UAlberta-EcoCar/FCC-code-2015-2016/README.md

Code for Ualberta ecocar team hydrogen fuel fuel cell controller using an at32uc3c processor.
