UAlberta-EcoCar/FCC-code-2015-2016/Hardware/E-P-206-R1.2 Fuel Cell Control (Board to Board).brd

## EAGLE design Hardware/E-P-206-R1.2 Fuel Cell Control (Board to Board).brd (2017-02-24)

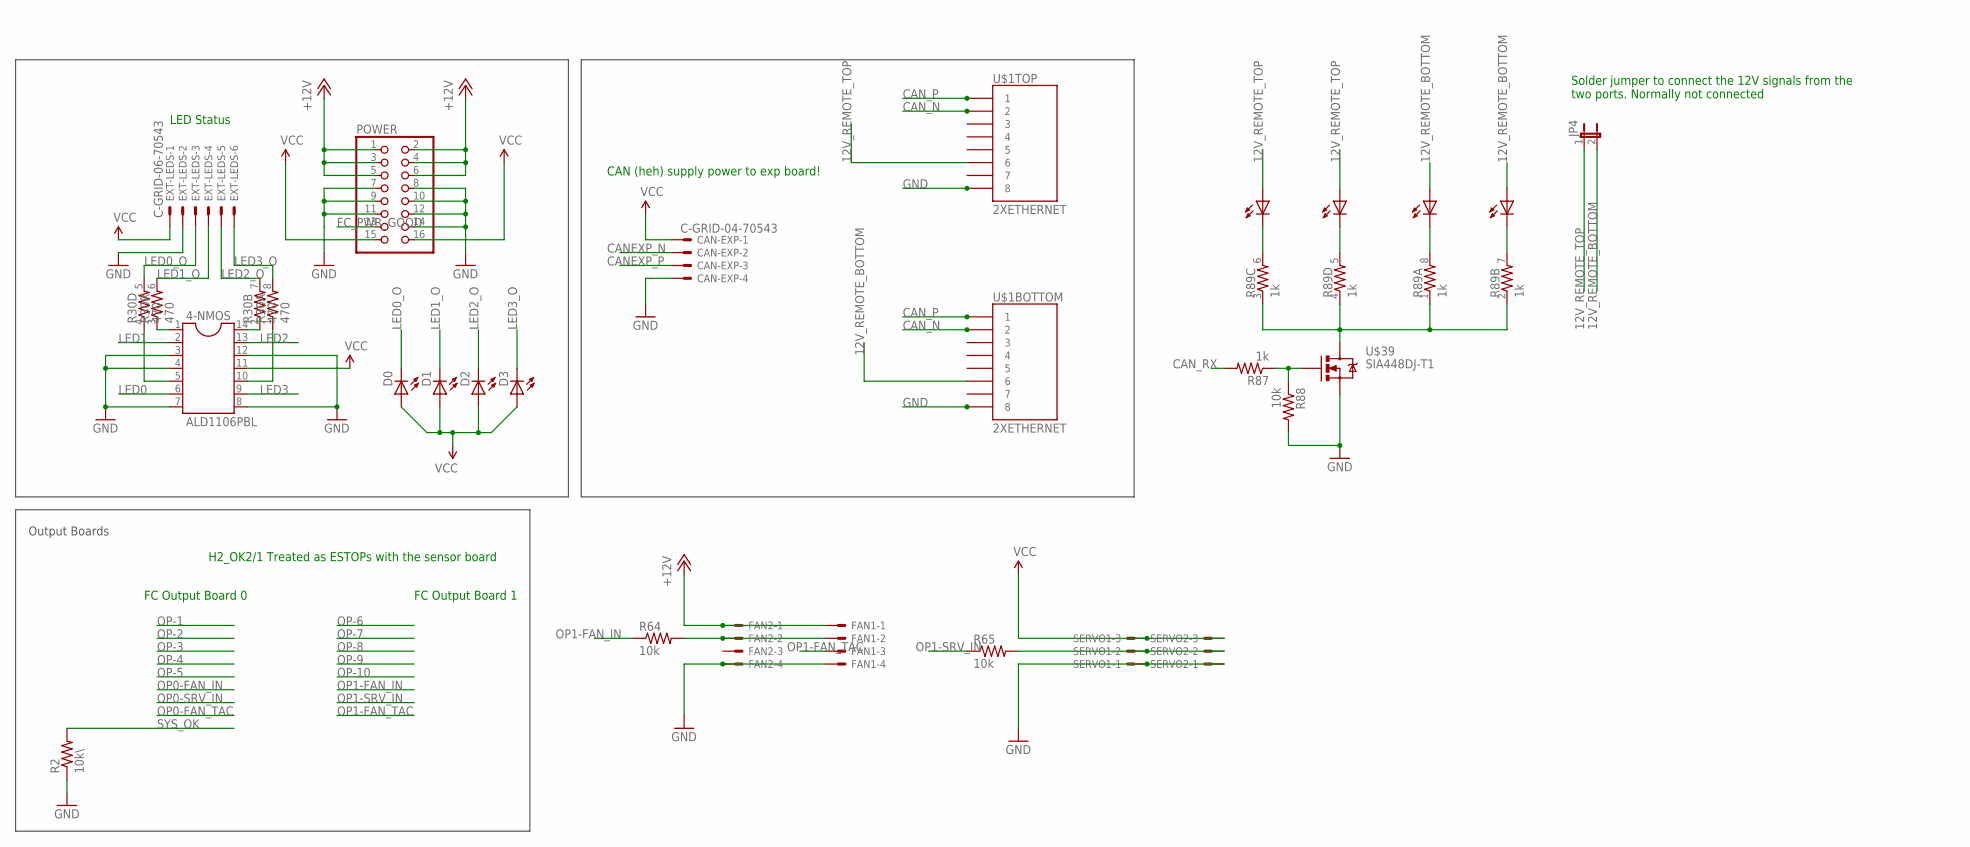
[picture p1: schematic E-P-206-R1.2 Fuel Cell Control (Board to Board).sch, sheet 1, Connectors]

Parts:
4-NMOS: ALD1106PBL; SOIC-14
CAN-EXP: C-GRID-04-70543; 70543-04
D0, D1, D2, D3: LED1206; LED-1206
EXT-LEDS: C-GRID-06-70543; 70543-06
FAN1, FAN2: C-GRID-04-70543; 70543-04
JP4: JUMPER-2SMD-NO; SJ_2S-NO
POWER: PINHD-2X8; 2X08
R2: 10k\; 0603-RES
R30: 470; 0603-ARV
R64, R65, R88: 10k; 0603-RES
R87: 1k; 0603-RES
R89: 1k; 0603-ARV
SERVO1, SERVO2: C-GRID-03-70543; 70543-03
U$1: 2XETHERNET
U$39: SIA448DJ-T1; SC70-6L

Connections:
12V_REMOTE_BOTTOM: JP4.2, U$1.B_6 (6), U$1.B_9 (A), U$1.B_11 (A)
12V_REMOTE_TOP: JP4.1, U$1.T_6 (6), U$1.T_9 (A), U$1.T_11 (A)
+12V: FAN1.1, FAN2.1, POWER.1, POWER.2, POWER.3, POWER.4, POWER.5, POWER.6; also elsewhere on the board
CANEXP_N: CAN-EXP.2; also elsewhere on the board
CANEXP_P: CAN-EXP.3; also elsewhere on the board
CAN_N: U$1.B_2 (2), U$1.T_2 (2); also elsewhere on the board
CAN_P: U$1.B_1 (1), U$1.T_1 (1); also elsewhere on the board
CAN_RX: R87.2; also elsewhere on the board
FC_PWR_GOOD: POWER.13; also elsewhere on the board
GND: 4-NMOS.3, 4-NMOS.4, 4-NMOS.7, 4-NMOS.8, 4-NMOS.12, CAN-EXP.4, EXT-LEDS.2, FAN1.4, FAN2.4, POWER.7, POWER.8, POWER.9, POWER.10, POWER.11, POWER.12, POWER.14, R2.1, R88.2, SERVO1.1, SERVO2.1, U$1.B_8 (8), U$1.T_8 (8), U$39.S@0 (S), U$39.S@1 (S); also elsewhere on the board
LED0: 4-NMOS.6; also elsewhere on the board
LED0_O: D0.C, EXT-LEDS.3, R30.5 (2)
LED1: 4-NMOS.2; also elsewhere on the board
LED1_O: D1.C, EXT-LEDS.4, R30.6 (2)
LED2: 4-NMOS.13; also elsewhere on the board
LED2_O: D2.C, EXT-LEDS.5, R30.7 (2)
LED3: 4-NMOS.9; also elsewhere on the board
LED3_O: D3.C, EXT-LEDS.6, R30.8 (2)
unnamed: 4-NMOS.5, R30.4 (1)
unnamed: 4-NMOS.1, R30.3 (1)
unnamed: 4-NMOS.14, R30.2 (1)
unnamed: 4-NMOS.10, R30.1
unnamed: R89.7 (2), U$1.B_10 (C)
unnamed: R89.5 (2), U$1.T_12 (C)
unnamed: R87.1, R88.1, U$39.G
unnamed: R89.6 (2), U$1.T_10 (C)
unnamed: R89.8 (2), U$1.B_12 (C)
unnamed: FAN1.2, FAN2.2, R64.2
unnamed: R65.2, SERVO1.2, SERVO2.2
unnamed: R89.1, R89.2 (1), R89.3 (1), R89.4 (1), U$39.D
OP1-FAN_IN: R64.1; also elsewhere on the board
OP1-FAN_TAC: FAN1.3; also elsewhere on the board
OP1-SRV_IN: R65.1; also elsewhere on the board
SYS_OK: R2.2; also elsewhere on the board
VCC: 4-NMOS.11, CAN-EXP.1, D0.A, D1.A, D2.A, D3.A, EXT-LEDS.1, POWER.15, POWER.16, SERVO1.3, SERVO2.3; also elsewhere on the board

Notes on the sheet:
FC Output Board 0
Output Boards
FC Output Board 1
LED Status
H2_OK2/1 Treated as ESTOPs with the sensor board
CAN (heh) supply power to exp board!
Solder jumper to connect the 12V signals from the two ports. Normally not connected

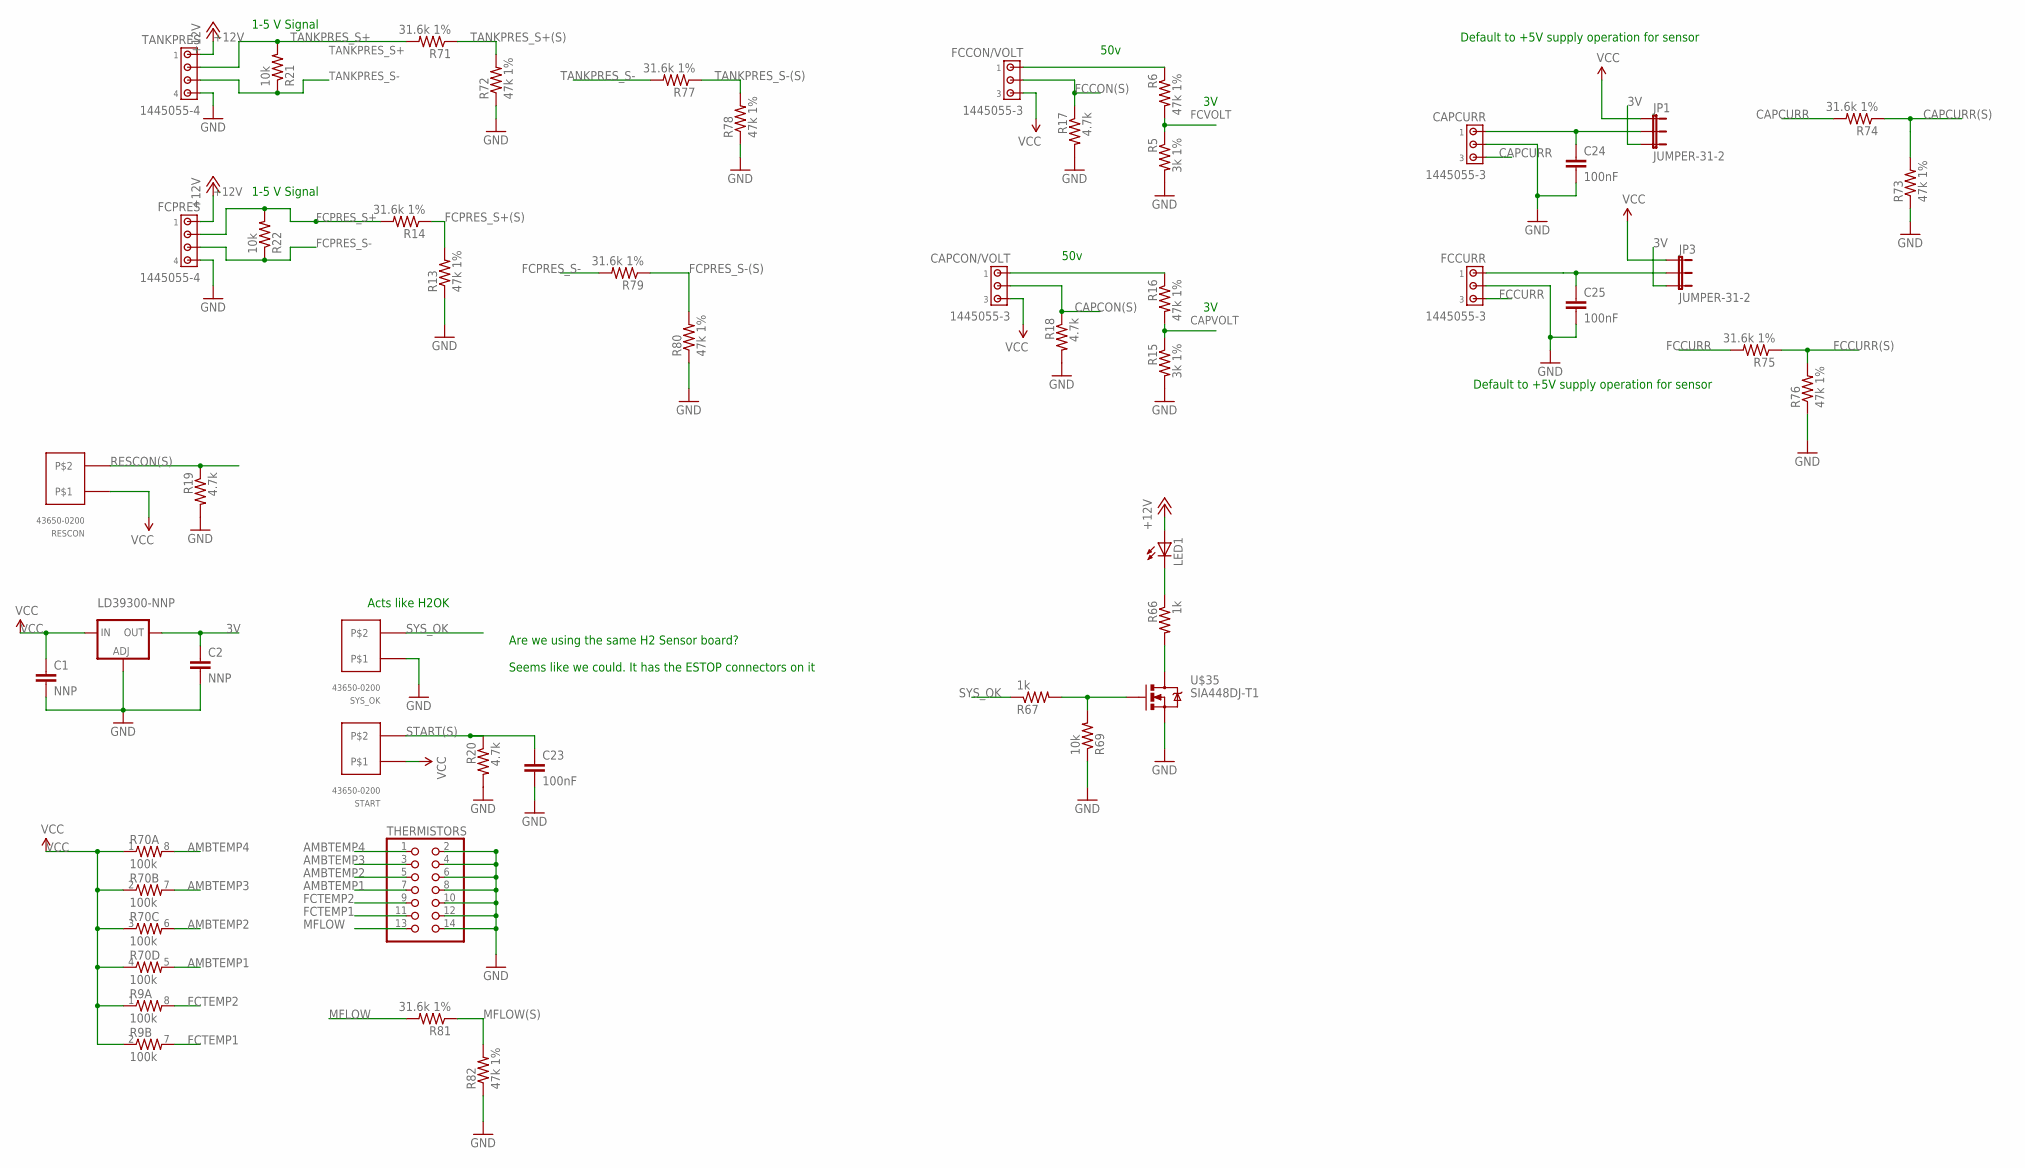
[picture p2: schematic E-P-206-R1.2 Fuel Cell Control (Board to Board).sch, sheet 2, Sensors]

Parts:
C1, C2: NNP; 1206
C23, C24, C25: 100nF; 0603-CAP
CAPCON/VOLT: 1445055-3
CAPCURR: 1445055-3
FCCON/VOLT: 1445055-3
FCCURR: 1445055-3
FCPRES: 1445055-4
JP1, JP3: JUMPER-31-2; SJ_3_PASTE1&2
LD39300-NNP: LD117ADT50TR; DPACK
LED1: LED1206; LED-1206
R5, R15: 3k 1%; 0603-RES
R6, R13, R16, R72, R73, R76, R78, R80, R82: 47k 1%; 0603-RES
R9, R70: 100k; 0603-ARV
R14, R71, R74, R75, R77, R79, R81: 31.6k 1%; 0603-RES
R17, R18, R19, R20: 4.7k; 0603-RES
R21, R22, R69: 10k; 0603-RES
R66, R67: 1k; 0603-RES
RESCON: 43650-0200
START: 43650-0200
SYS_OK: 43650-0200
TANKPRES: 1445055-4
THERMISTORS: PINHD-2X7; 2X07
U$35: SIA448DJ-T1; SC70-6L

Connections:
3V: C2.1, JP1.3, JP3.3, LD39300-NNP.4 (OUT)
+12V: FCPRES.1, LED1.A, TANKPRES.1; also elsewhere on the board
AMBTEMP1: R70.5 (2), THERMISTORS.7; also elsewhere on the board
AMBTEMP2: R70.6 (2), THERMISTORS.5; also elsewhere on the board
AMBTEMP3: R70.7 (2), THERMISTORS.3; also elsewhere on the board
AMBTEMP4: R70.8 (2), THERMISTORS.1; also elsewhere on the board
CAPCON(S): CAPCON/VOLT.2, R18.1; also elsewhere on the board
CAPCURR: CAPCURR.3, R74.2
CAPCURR(S): R73.2, R74.1; also elsewhere on the board
CAPVOLT: R15.1, R16.2; also elsewhere on the board
FCCON(S): FCCON/VOLT.2, R17.1; also elsewhere on the board
FCCURR: FCCURR.3, R75.2
FCCURR(S): R75.1, R76.2; also elsewhere on the board
FCPRES_S+: FCPRES.2, R14.2, R22.2
FCPRES_S+(S): R13.2, R14.1; also elsewhere on the board
FCPRES_S-: FCPRES.3, R22.1, R79.2
FCPRES_S-(S): R79.1, R80.2; also elsewhere on the board
FCTEMP1: R9.7 (2), THERMISTORS.11; also elsewhere on the board
FCTEMP2: R9.8 (2), THERMISTORS.9; also elsewhere on the board
FCVOLT: R5.1, R6.2; also elsewhere on the board
FCVOLT+: FCCON/VOLT.1, R6.1
FCVOLT+1: CAPCON/VOLT.1, R16.1
GND: C1.2, C2.2, C23.2, C24.2, C25.2, CAPCURR.2, FCCURR.2, FCPRES.4, LD39300-NNP.1 (ADJ), R5.2, R13.1, R15.2, R17.2, R18.2, R19.2, R20.2, R69.1, R72.1, R73.1, R76.1, R78.1, R80.1, R82.1, SYS_OK.P$2, TANKPRES.4, THERMISTORS.2, THERMISTORS.4, THERMISTORS.6, THERMISTORS.8, THERMISTORS.10, THERMISTORS.12, THERMISTORS.14, U$35.S@0 (S), U$35.S@1 (S); also elsewhere on the board
MFLOW: R81.2, THERMISTORS.13
MFLOW(S): R81.1, R82.2; also elsewhere on the board
unnamed: R66.2, U$35.D
unnamed: R67.2, R69.2, U$35.G
unnamed: LED1.C, R66.1
unnamed: C24.1, CAPCURR.1, JP1.2
unnamed: C25.1, FCCURR.1, JP3.2
RESCON(S): R19.1, RESCON.P$1; also elsewhere on the board
START(S): C23.1, R20.1, START.P$1; also elsewhere on the board
SYS_OK: R67.1, SYS_OK.P$1; also elsewhere on the board
TANKPRES_S+: R21.2, R71.2, TANKPRES.2
TANKPRES_S+(S): R71.1, R72.2; also elsewhere on the board
TANKPRES_S-: R21.1, R77.2, TANKPRES.3
TANKPRES_S-(S): R77.1, R78.2; also elsewhere on the board
VCC: C1.1, CAPCON/VOLT.3, FCCON/VOLT.3, JP1.1, JP3.1, LD39300-NNP.3 (IN), R9.1, R9.2 (1), R70.1, R70.2 (1), R70.3 (1), R70.4 (1), RESCON.P$2, START.P$2; also elsewhere on the board

Notes on the sheet:
Are we using the same H2 Sensor board? Seems like we could. It has the ESTOP connectors on it
Acts like H2OK
1-5 V Signal
50v
Default to +5V supply operation for sensor

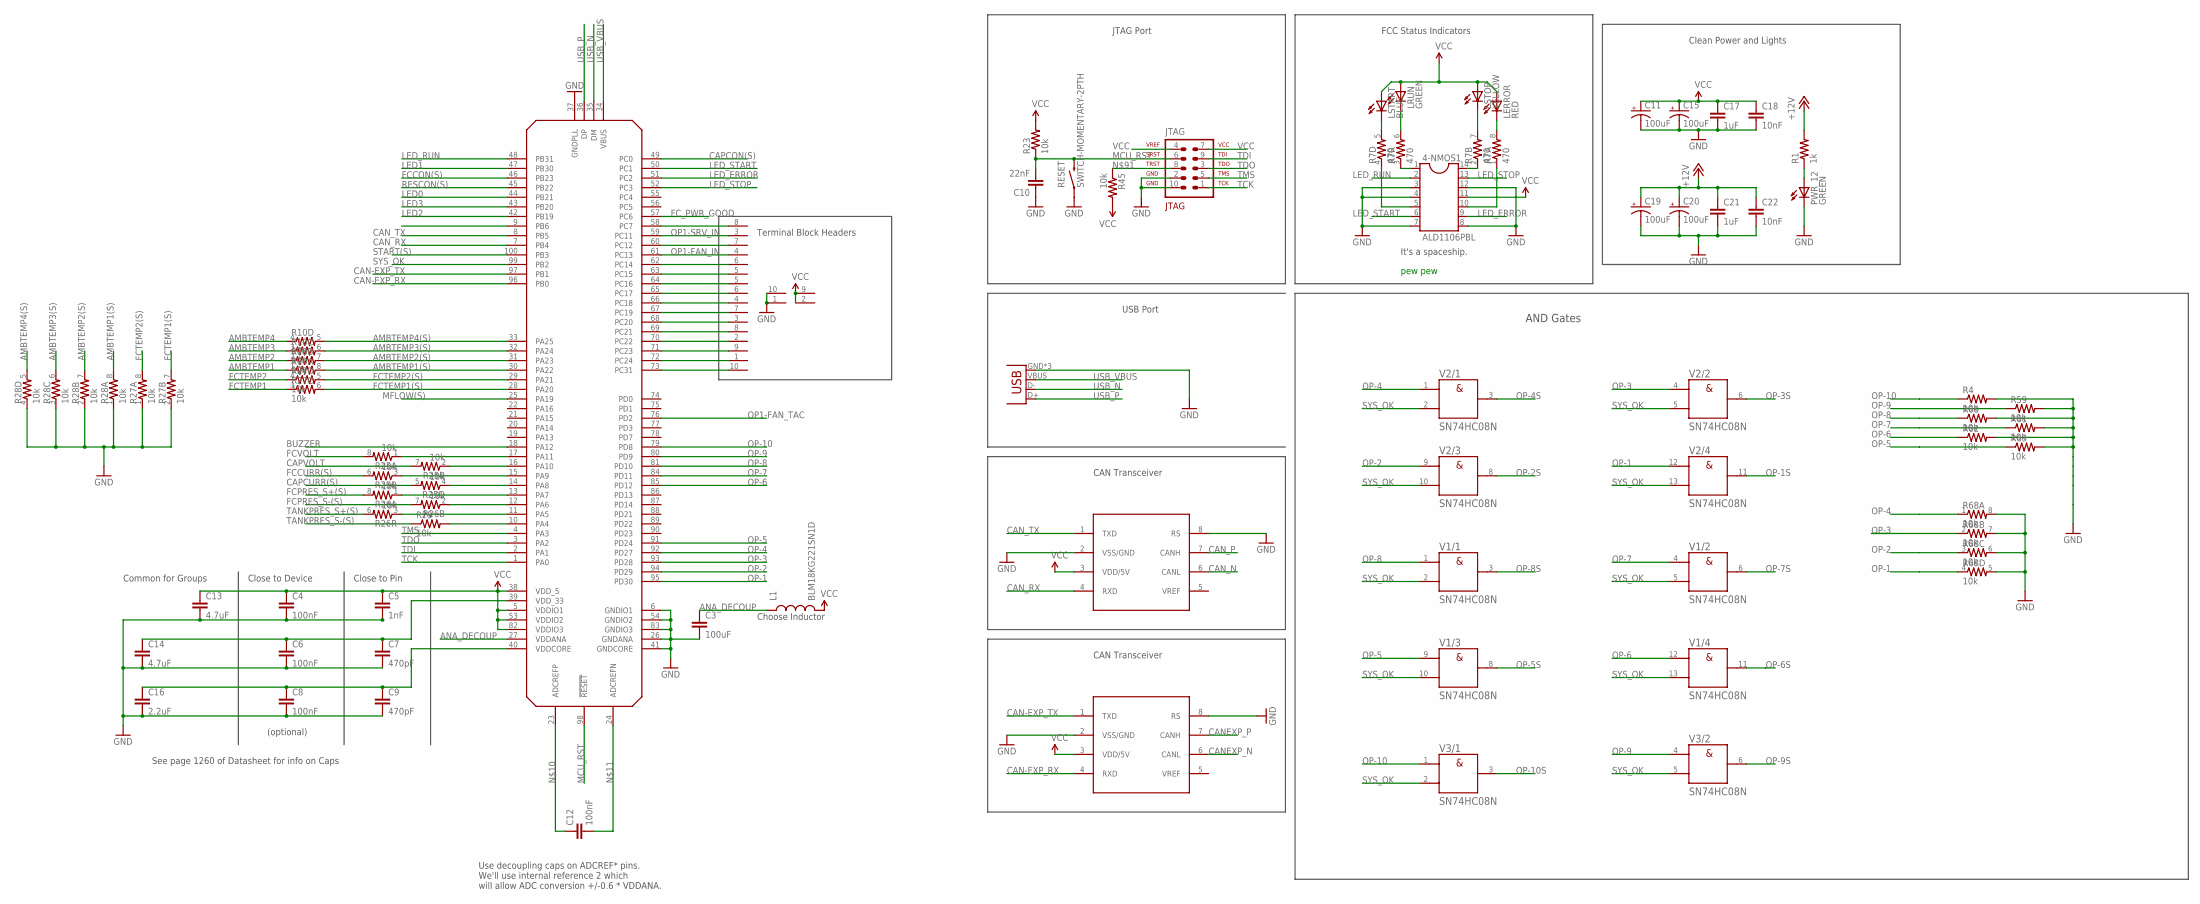
[picture p3: schematic E-P-206-R1.2 Fuel Cell Control (Board to Board).sch, sheet 3, MCU]

Parts:
4-NMOS1: ALD1106PBL; SOIC-14
C3: 100uF; 0805
C4, C6, C8: 100nF; 0603-CAP
C5: 1nF; 0603-CAP
C7, C9: 470pF; 0603-CAP
C10: 22nF; 0603-CAP
C11, C15, C19, C20: 100uF; PANASONIC_C
C12: 100nF; 0805
C13, C14: 4.7uF; 0805
C16: 2.2uF; 0805
C17, C21: 1uF; 0805
C18, C22: 10nF; 0603-CAP
JP2: USB; USB-MICROB
JTAG: 2x5; AVR-JTAG-10
L1: BLM18KG221SN1D; 0603
LERROR: RED; LED-1206
LRUN: GREEN; LED-1206
LSTART: BLUE; LED-1206
LSTOP: YELLOW; LED-1206
MCU: AT32UC3C1512; TQFP100
PWR_12: GREEN; LED-1206
R1: 1k; 0603-RES
R4, R23, R29, R45, R59, R60, R61, R62, R63: 10k; 0603-RES
R7: 470; 0603-ARV
R10, R25, R26, R27, R28, R68: 10k; 0603-ARV
RESET: SWITCH-MOMENTARY-2PTH; TACTILE-PTH
U$2, U$3: 10X1PCBBLOCK
U$4, U$36: MCP2551; 8-SOIC
V1, V2, V3: SN74HC08N; DIL14

Connections:
+12V: C19.+, C20.+, C21.1, C22.1, R1.2; also elsewhere on the board
AMBTEMP1: R10.1; also elsewhere on the board
AMBTEMP1(S): MCU.30 (PA22), R10.8 (2), R28.8 (2)
AMBTEMP2: R10.2 (1); also elsewhere on the board
AMBTEMP2(S): MCU.31 (PA23), R10.7 (2), R28.7 (2)
AMBTEMP3: R10.3 (1); also elsewhere on the board
AMBTEMP3(S): MCU.32 (PA24), R10.6 (2), R28.6 (2)
AMBTEMP4: R10.4 (1); also elsewhere on the board
AMBTEMP4(S): MCU.33 (PA25), R10.5 (2), R28.5 (2)
ANA_DECOUP: C3.1, L1.1, MCU.27 (VDDANA)
BUZZER: MCU.18 (PA12); also elsewhere on the board
CAN-EXP_RX: MCU.96 (PB0), U$36.4 (RXD)
CAN-EXP_TX: MCU.97 (PB1), U$36.1 (TXD)
CANEXP_N: U$36.6 (CANL); also elsewhere on the board
CANEXP_P: U$36.7 (CANH); also elsewhere on the board
CAN_N: U$4.6 (CANL); also elsewhere on the board
CAN_P: U$4.7 (CANH); also elsewhere on the board
CAN_RX: MCU.7 (PB4), U$4.4 (RXD); also elsewhere on the board
CAN_TX: MCU.8 (PB5), U$4.1 (TXD)
CAPCON(S): MCU.49 (PC0); also elsewhere on the board
CAPCURR(S): R25.5 (2); also elsewhere on the board
CAPVOLT: R25.7 (2); also elsewhere on the board
FCCON(S): MCU.46 (PB23); also elsewhere on the board
FCCURR(S): R25.6 (2); also elsewhere on the board
FCPRES_S+(S): R26.8 (2); also elsewhere on the board
FCPRES_S-(S): R26.7 (2); also elsewhere on the board
FCTEMP1: R27.3 (1); also elsewhere on the board
FCTEMP1(S): MCU.28 (PA20), R27.6 (2), R27.7 (2)
FCTEMP2: R27.4 (1); also elsewhere on the board
FCTEMP2(S): MCU.29 (PA21), R27.5 (2), R27.8 (2)
FCVOLT: R25.8 (2); also elsewhere on the board
FC_PWR_GOOD: MCU.57 (PC6); also elsewhere on the board
GND: 4-NMOS1.3, 4-NMOS1.4, 4-NMOS1.7, 4-NMOS1.8, 4-NMOS1.12, C3.2, C4.2, C5.2, C6.2, C7.2, C8.2, C9.2, C10.1, C11.-, C13.2, C14.2, C15.-, C16.2, C17.2, C18.2, C19.-, C20.-, C21.2, C22.2, JP2.GND, JP2.MT1 (GND), JP2.MT2 (GND), JTAG.2, JTAG.10, MCU.6 (GNDIO1), MCU.26 (GNDANA), MCU.37 (GNDPLL), MCU.41 (GNDCORE), MCU.54 (GNDIO2), MCU.83 (GNDIO3), PWR_12.C, R4.2, R27.1, R27.2 (1), R28.1, R28.2 (1), R28.3 (1), R28.4 (1), R59.2, R60.2, R61.2, R62.2, R63.2, R68.5 (2), R68.6 (2), R68.7 (2), R68.8 (2), RESET.1, U$2.10, U$3.1, U$4.2 (VSS/GND), U$4.8 (RS), U$36.2 (VSS/GND), U$36.8 (RS), V1.7 (-UB), V2.7 (-UB), V3.7 (-UB); also elsewhere on the board
LED0: MCU.44 (PB21); also elsewhere on the board
LED1: MCU.47 (PB30); also elsewhere on the board
LED2: MCU.42 (PB19); also elsewhere on the board
LED3: MCU.43 (PB20); also elsewhere on the board
LED_ERROR: 4-NMOS1.9, MCU.51 (PC2)
LED_RUN: 4-NMOS1.2, MCU.48 (PB31)
LED_START: 4-NMOS1.6, MCU.50 (PC1)
LED_STOP: 4-NMOS1.13, MCU.52 (PC3)
MCU_RST: C10.2, JTAG.6, MCU.98 (!RESET), R23.1, RESET.3 (2)
MFLOW(S): MCU.25 (PA19); also elsewhere on the board
unnamed: MCU.10 (PA4), R29.2
unnamed: MCU.12 (PA6), R26.2 (1)
unnamed: MCU.13 (PA7), R26.1
unnamed: C6.1, C7.1, C14.1, MCU.39 (VDD_33)
unnamed: C8.1, C9.1, C16.1, MCU.40 (VDDCORE)
unnamed: C12.1, MCU.23 (ADCREFP)
unnamed: C12.2, MCU.24 (ADCREFN)
unnamed: MCU.72 (PC24), U$2.1
unnamed: MCU.11 (PA5), R26.3 (1)
unnamed: MCU.70 (PC22), U$2.2
unnamed: MCU.68 (PC20), U$2.3
unnamed: MCU.14 (PA8), R25.4 (1)
unnamed: MCU.66 (PC18), U$2.4
unnamed: MCU.64 (PC16), U$2.5
unnamed: MCU.62 (PC14), U$2.6
unnamed: LSTART.C, R7.5 (2)
unnamed: LRUN.C, R7.6 (2)
unnamed: MCU.15 (PA9), R25.3 (1)
unnamed: MCU.16 (PA10), R25.2 (1)
unnamed: MCU.17 (PA11), R25.1
unnamed: MCU.60 (PC12), U$2.7
unnamed: MCU.58 (PC7), U$2.8
unnamed: 4-NMOS1.5, R7.4 (1)
unnamed: 4-NMOS1.1, R7.3 (1)
unnamed: PWR_12.A, R1.1
unnamed: MCU.63 (PC15), U$3.5
unnamed: MCU.65 (PC17), U$3.6
unnamed: MCU.67 (PC19), U$3.7
unnamed: MCU.69 (PC21), U$3.8
unnamed: MCU.71 (PC23), U$3.9
unnamed: MCU.73 (PC31), U$3.10
unnamed: 4-NMOS1.14, R7.2 (1)
unnamed: 4-NMOS1.10, R7.1
unnamed: LSTOP.C, R7.7 (2)
unnamed: LERROR.C, R7.8 (2)
unnamed: JTAG.8, R45.1
OP1-FAN_IN: MCU.61 (PC13), U$3.4; also elsewhere on the board
OP1-FAN_TAC: MCU.76 (PD2); also elsewhere on the board
OP1-SRV_IN: MCU.59 (PC11), U$3.3; also elsewhere on the board
OP-1: MCU.95 (PD30), R68.4 (1), V2.12 (A)
OP-1S: V2.11 (Y); also elsewhere on the board
OP-2: MCU.94 (PD29), R68.3 (1), V2.9 (A)
OP-2S: V2.8 (Y); also elsewhere on the board
OP-3: MCU.93 (PD28), R68.2 (1), V2.4 (A)
OP-3S: V2.6 (Y); also elsewhere on the board
OP-4: MCU.92 (PD27), R68.1, V2.1 (A)
OP-4S: V2.3 (Y); also elsewhere on the board
OP-5: MCU.91 (PD24), R63.1, V1.9 (A)
OP-5S: V1.8 (Y); also elsewhere on the board
OP-6: MCU.85 (PD12), R62.1, V1.12 (A)
OP-6S: V1.11 (Y); also elsewhere on the board
OP-7: MCU.84 (PD11), R61.1, V1.4 (A)
OP-7S: V1.6 (Y); also elsewhere on the board
OP-8: MCU.81 (PD10), R60.1, V1.1 (A)
OP-8S: V1.3 (Y); also elsewhere on the board
OP-9: MCU.80 (PD9), R59.1, V3.4 (A)
OP-9S: V3.6 (Y); also elsewhere on the board
OP-10: MCU.79 (PD8), R4.1, V3.1 (A)
OP-10S: V3.3 (Y); also elsewhere on the board
RESCON(S): MCU.45 (PB22); also elsewhere on the board
START(S): MCU.100 (PB3); also elsewhere on the board
SYS_OK: MCU.99 (PB2), V1.2 (B), V1.5 (B), V1.10 (B), V1.13 (B), V2.2 (B), V2.5 (B), V2.10 (B), V2.13 (B), V3.2 (B), V3.5 (B); also elsewhere on the board
TANKPRES_S+(S): R26.6 (2); also elsewhere on the board
TANKPRES_S-(S): R29.1; also elsewhere on the board
TCK: JTAG.1, MCU.1 (PA0)
TDI: JTAG.9, MCU.2 (PA1)
TDO: JTAG.3, MCU.3 (PA2)
TMS: JTAG.5, MCU.4 (PA3)
USB_N: JP2.D-, MCU.35 (DM)
USB_P: JP2.D+, MCU.36 (DP)
USB_VBUS: JP2.VBUS, MCU.34 (VBUS)
VCC: 4-NMOS1.11, C4.1, C5.1, C11.+, C13.1, C15.+, C17.1, C18.1, JTAG.4, JTAG.7, L1.2, LERROR.A, LRUN.A, LSTART.A, LSTOP.A, MCU.5 (VDDIO1), MCU.38 (VDD_5), MCU.53 (VDDIO2), MCU.82 (VDDIO3), R23.2, R45.2, U$2.9, U$3.2, U$4.3 (VDD/5V), U$36.3 (VDD/5V), V1.14 (+UB), V2.14 (+UB), V3.14 (+UB); also elsewhere on the board

Notes on the sheet:
Choose Inductor
Use decoupling caps on ADCREF* pins. We'll use internal reference 2 which will allow ADC conversion +/-0.6 * VDDANA.
Close to Pin
Close to Device
Common for Groups
JTAG Port
USB Port
(optional)
See page 1260 of Datasheet for info on Caps
CAN Transceiver
Terminal Block Headers
Clean Power and Lights
FCC Status Indicators
It's a spaceship.
pew pew
AND Gates

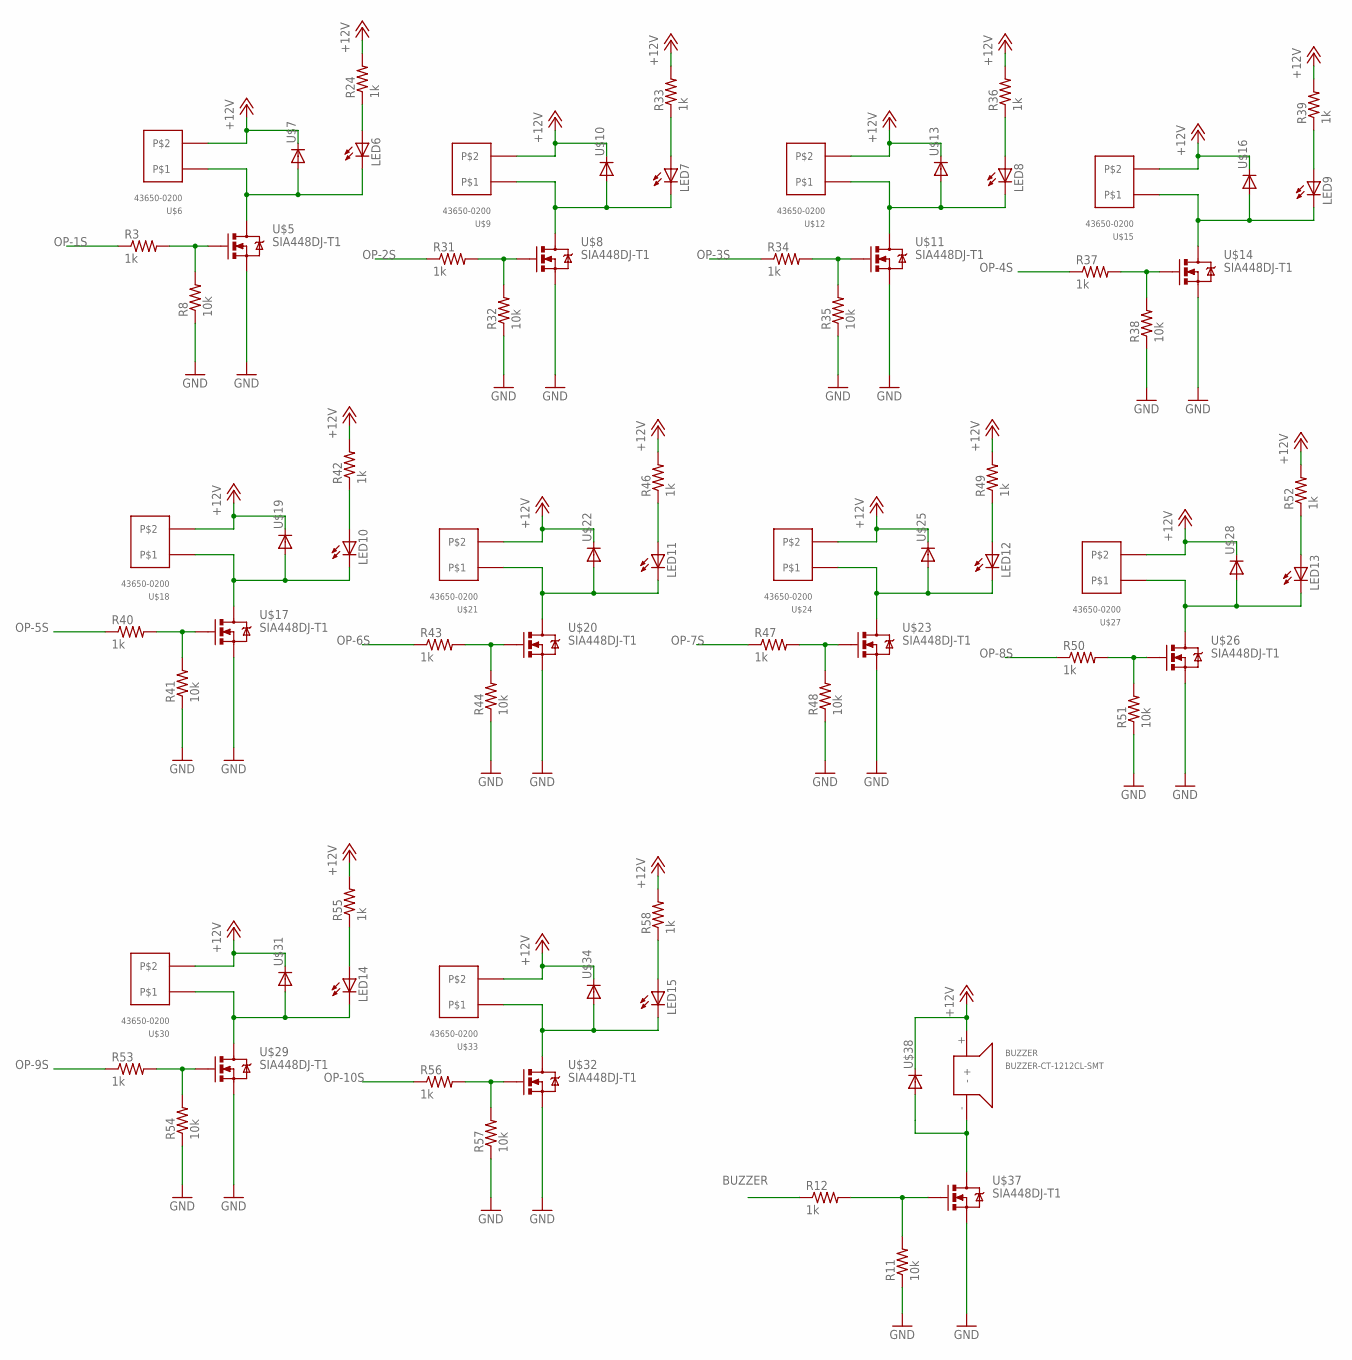
[picture p4: schematic E-P-206-R1.2 Fuel Cell Control (Board to Board).sch, sheet 4, Output Drivers]

Parts:
BUZZER: BUZZER-CT-1212CL-SMT; CT-1212CL-SMT
LED6, LED7, LED8, LED9, LED10, LED11, LED12, LED13, LED14, LED15: LED1206; LED-1206
R3, R12, R24, R31, R33, R34, R36, R37, R39, R40, R42, R43, R46, R47, R49, R50, R52, R53, R55, R56, R58: 1k; 0603-RES
R8, R11, R32, R35, R38, R41, R44, R48, R51, R54, R57: 10k; 0603-RES
U$5, U$8, U$11, U$14, U$17, U$20, U$23, U$26, U$29, U$32, U$37: SIA448DJ-T1; SC70-6L
U$6, U$9, U$12, U$15, U$18, U$21, U$24, U$27, U$30, U$33: 43650-0200
U$7, U$10, U$13, U$16, U$19, U$22, U$25, U$28, U$31, U$34, U$38: DIODE-DO214AC; DO214AC

Connections:
+12V: BUZZER.+, R24.2, R33.2, R36.2, R39.2, R42.2, R46.2, R49.2, R52.2, R55.2, R58.2, U$6.P$1, U$7.C, U$9.P$1, U$10.C, U$12.P$1, U$13.C, U$15.P$1, U$16.C, U$18.P$1, U$19.C, U$21.P$1, U$22.C, U$24.P$1, U$25.C, U$27.P$1, U$28.C, U$30.P$1, U$31.C, U$33.P$1, U$34.C, U$38.C; also elsewhere on the board
BUZZER: R12.1; also elsewhere on the board
GND: R8.1, R11.1, R32.1, R35.1, R38.1, R41.1, R44.1, R48.1, R51.1, R54.1, R57.1, U$5.S@0 (S), U$5.S@1 (S), U$8.S@0 (S), U$8.S@1 (S), U$11.S@0 (S), U$11.S@1 (S), U$14.S@0 (S), U$14.S@1 (S), U$17.S@0 (S), U$17.S@1 (S), U$20.S@0 (S), U$20.S@1 (S), U$23.S@0 (S), U$23.S@1 (S), U$26.S@0 (S), U$26.S@1 (S), U$29.S@0 (S), U$29.S@1 (S), U$32.S@0 (S), U$32.S@1 (S), U$37.S@0 (S), U$37.S@1 (S); also elsewhere on the board
unnamed: R3.2, R8.2, U$5.G
unnamed: R11.2, R12.2, U$37.G
unnamed: LED6.A, R24.1
unnamed: LED6.C, U$5.D, U$6.P$2, U$7.A
unnamed: R31.2, R32.2, U$8.G
unnamed: LED7.C, U$8.D, U$9.P$2, U$10.A
unnamed: LED7.A, R33.1
unnamed: R34.2, R35.2, U$11.G
unnamed: BUZZER.-, U$37.D, U$38.A
unnamed: LED8.C, U$11.D, U$12.P$2, U$13.A
unnamed: LED8.A, R36.1
unnamed: R37.2, R38.2, U$14.G
unnamed: LED9.C, U$14.D, U$15.P$2, U$16.A
unnamed: LED9.A, R39.1
unnamed: R40.2, R41.2, U$17.G
unnamed: LED10.C, U$17.D, U$18.P$2, U$19.A
unnamed: LED13.A, R52.1
unnamed: R43.2, R44.2, U$20.G
unnamed: LED11.C, U$20.D, U$21.P$2, U$22.A
unnamed: LED12.A, R49.1
unnamed: R47.2, R48.2, U$23.G
unnamed: LED12.C, U$23.D, U$24.P$2, U$25.A
unnamed: LED11.A, R46.1
unnamed: R50.2, R51.2, U$26.G
unnamed: LED13.C, U$26.D, U$27.P$2, U$28.A
unnamed: LED10.A, R42.1
unnamed: R53.2, R54.2, U$29.G
unnamed: LED14.C, U$29.D, U$30.P$2, U$31.A
unnamed: LED14.A, R55.1
unnamed: R56.2, R57.2, U$32.G
unnamed: LED15.C, U$32.D, U$33.P$2, U$34.A
unnamed: LED15.A, R58.1
OP-1S: R3.1; also elsewhere on the board
OP-2S: R31.1; also elsewhere on the board
OP-3S: R34.1; also elsewhere on the board
OP-4S: R37.1; also elsewhere on the board
OP-5S: R40.1; also elsewhere on the board
OP-6S: R43.1; also elsewhere on the board
OP-7S: R47.1; also elsewhere on the board
OP-8S: R50.1; also elsewhere on the board
OP-9S: R53.1; also elsewhere on the board
OP-10S: R56.1; also elsewhere on the board

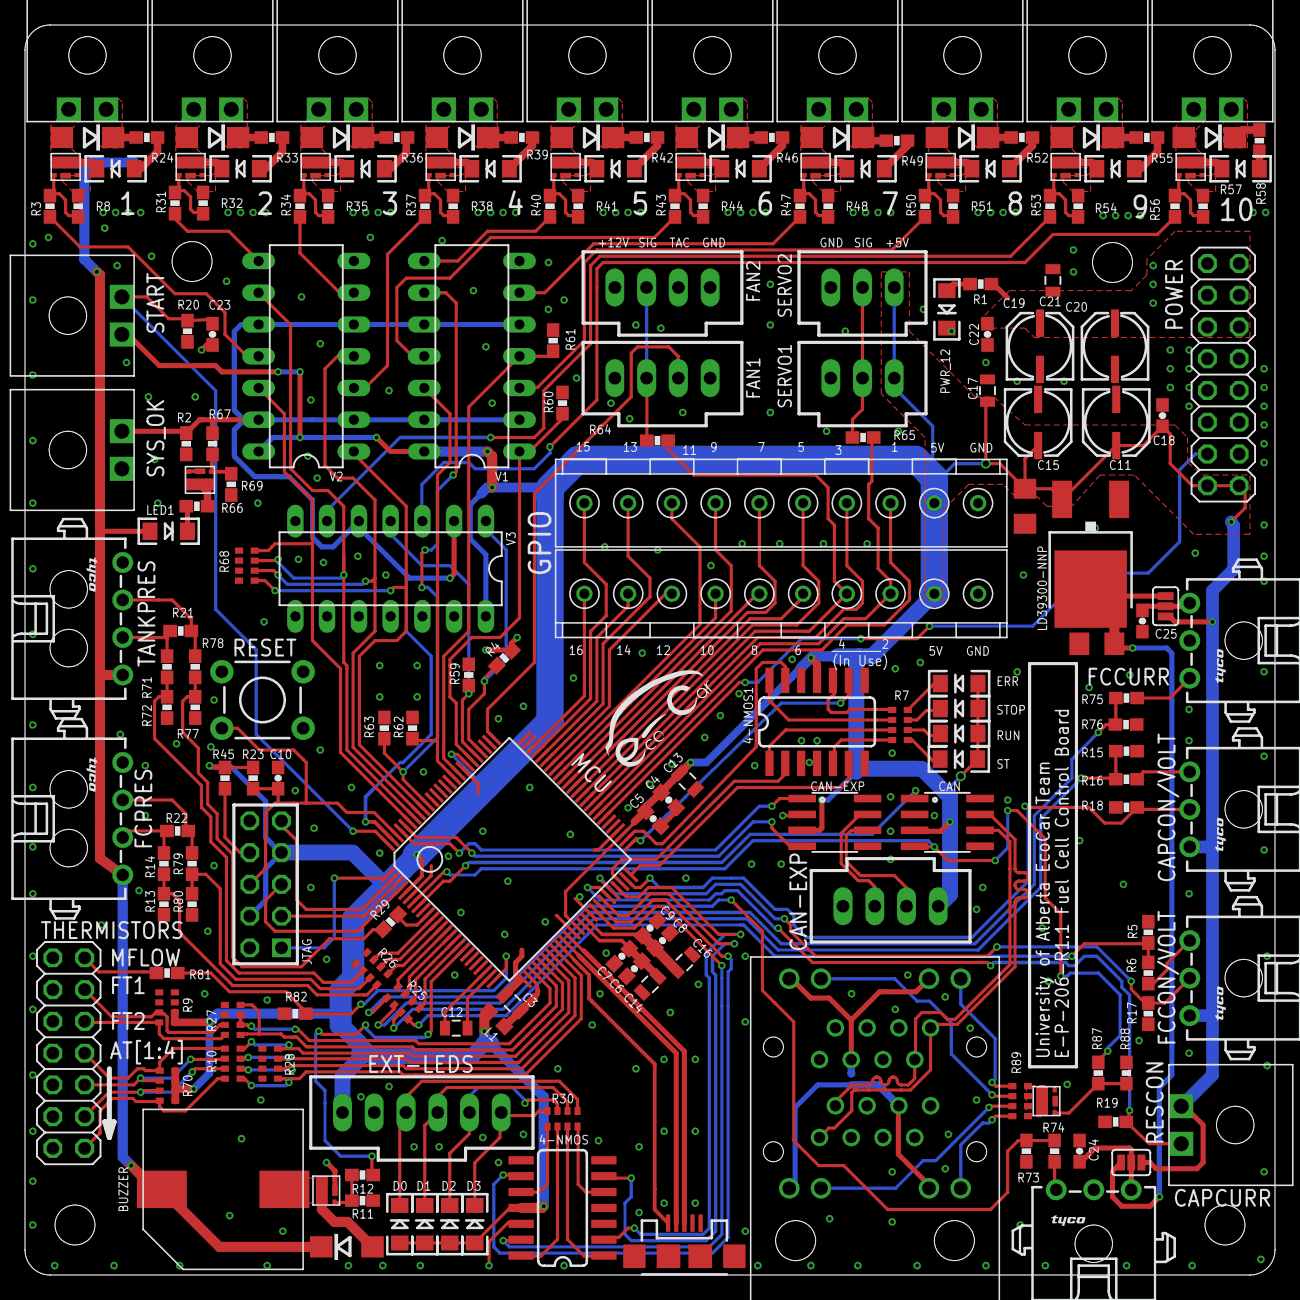
[picture p5: board E-P-206-R1.2 Fuel Cell Control (Board to Board).brd from above]

Board: 2 copper layers, 100.0 x 100.0 mm, 201 parts (1 on the bottom side), 180 nets.
