UAlberta-EcoCar/FCC-code-2015-2016/Hardware/E-P-206-R2.0.0_Fuel_Cell_Controller.brd

## EAGLE design Hardware/E-P-206-R2.0.0_Fuel_Cell_Controller.brd (2017-02-24)

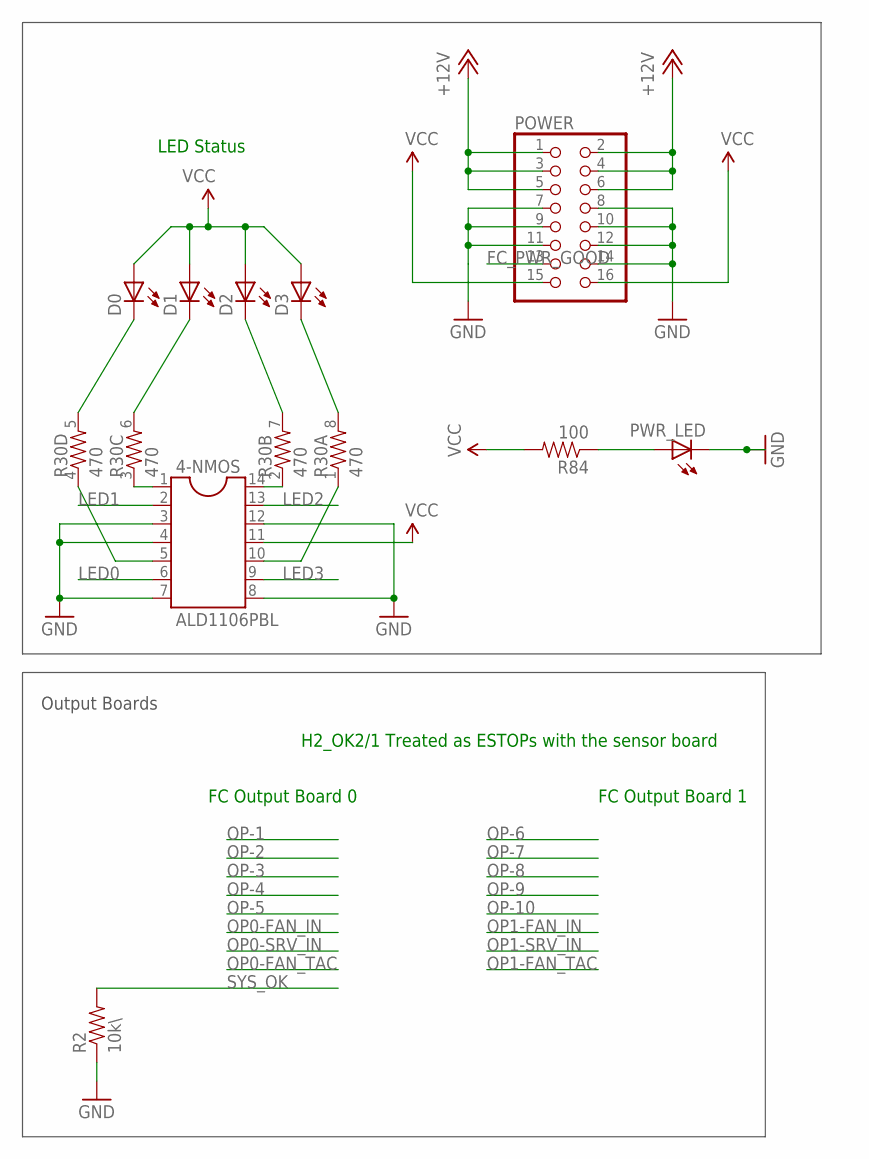
[picture p6: schematic E-P-206-R2.0.0_Fuel_Cell_Controller.sch, sheet 1, Connectors]

Parts:
4-NMOS: ALD1106PBL; SOIC-14
D0, D1, D2, D3: LED1206; LED-1206
POWER: PINHD-2X8; 2X08
PWR_LED: LED1206; LED-1206
R2: 10k\; 0603-RES
R30: 470; 0603-ARV
R84: 100; 0603-RES

Connections:
+12V: POWER.1, POWER.2, POWER.3, POWER.4, POWER.5, POWER.6; also elsewhere on the board
FC_PWR_GOOD: POWER.13
GND: 4-NMOS.3, 4-NMOS.4, 4-NMOS.7, 4-NMOS.8, 4-NMOS.12, POWER.7, POWER.8, POWER.9, POWER.10, POWER.11, POWER.12, POWER.14, PWR_LED.C, R2.1; also elsewhere on the board
LED0: 4-NMOS.6; also elsewhere on the board
LED0_O: D0.C, R30.5 (2)
LED1: 4-NMOS.2; also elsewhere on the board
LED1_O: D1.C, R30.6 (2)
LED2: 4-NMOS.13; also elsewhere on the board
LED2_O: D2.C, R30.7 (2)
LED3: 4-NMOS.9; also elsewhere on the board
LED3_O: D3.C, R30.8 (2)
unnamed: 4-NMOS.5, R30.4 (1)
unnamed: 4-NMOS.1, R30.3 (1)
unnamed: 4-NMOS.14, R30.2 (1)
unnamed: 4-NMOS.10, R30.1
unnamed: PWR_LED.A, R84.1
SYS_OK: R2.2; also elsewhere on the board
VCC: 4-NMOS.11, D0.A, D1.A, D2.A, D3.A, POWER.15, POWER.16, R84.2; also elsewhere on the board

Notes on the sheet:
FC Output Board 0
Output Boards
FC Output Board 1
LED Status
H2_OK2/1 Treated as ESTOPs with the sensor board
