UAlberta-EcoCar/FCC-code-2015-2016/Hardware/E-P-206-R2.0.0_Fuel_Cell_Controller.brd

## EAGLE design Hardware/E-P-206-R2.0.0_Fuel_Cell_Controller.brd (continued)

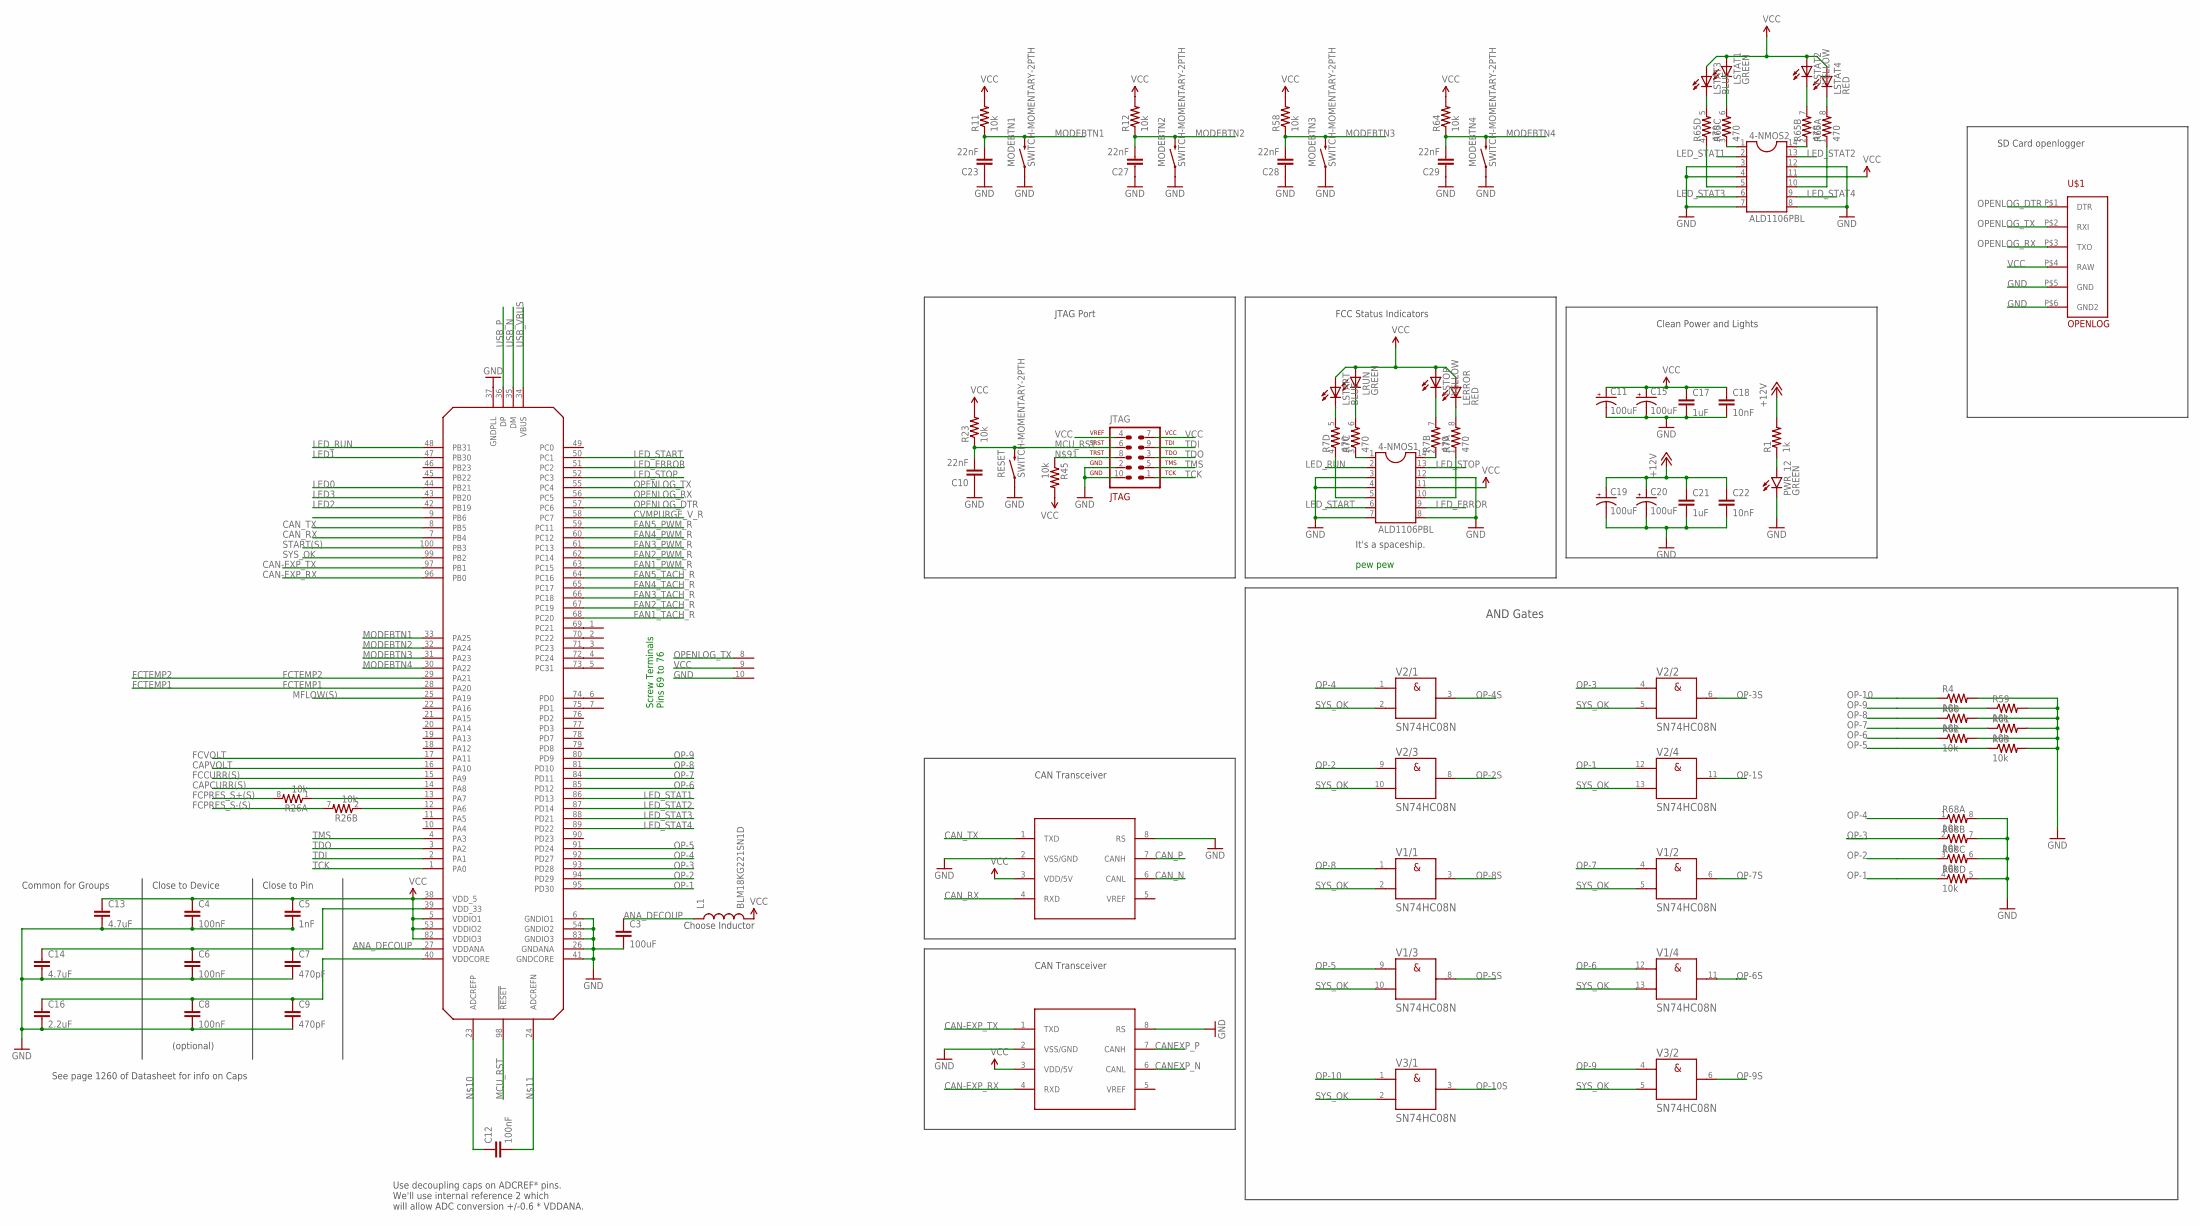
[picture p7: schematic E-P-206-R2.0.0_Fuel_Cell_Controller.sch, sheet 2, MCU]

Parts:
4-NMOS1, 4-NMOS2: ALD1106PBL; SOIC-14
C3: 100uF; 0805
C4, C6, C8: 100nF; 0603-CAP
C5: 1nF; 0603-CAP
C7, C9: 470pF; 0603-CAP
C10, C23, C27, C28, C29: 22nF; 0603-CAP
C11, C15, C19, C20: 100uF; PANASONIC_C
C12: 100nF; 0805
C13, C14: 4.7uF; 0805
C16: 2.2uF; 0805
C17, C21: 1uF; 0805
C18, C22: 10nF; 0603-CAP
JTAG: 2x5; AVR-JTAG-10
L1: BLM18KG221SN1D; 0603
LERROR: RED; LED-1206
LRUN: GREEN; LED-1206
LSTART: BLUE; LED-1206
LSTAT1: GREEN; LED-1206
LSTAT2: YELLOW; LED-1206
LSTAT3: BLUE; LED-1206
LSTAT4: RED; LED-1206
LSTOP: YELLOW; LED-1206
MCU: AT32UC3C1512; TQFP100
MODEBTN1, MODEBTN2, MODEBTN3, MODEBTN4: SWITCH-MOMENTARY-2PTH; TACTILE-PTH
PWR_12: GREEN; LED-1206
R1: 1k; 0603-RES
R4, R11, R12, R23, R45, R58, R59, R60, R61, R62, R63, R64: 10k; 0603-RES
R7, R65: 470; 0603-ARV
R26, R68: 10k; 0603-ARV
RESET: SWITCH-MOMENTARY-2PTH; TACTILE-PTH
U$1: OPENLOG
U$2: 10X1PCBBLOCK
U$4, U$36: MCP2551; 8-SOIC
V1, V2, V3: SN74HC08N; DIL14

Connections:
+12V: C19.+, C20.+, C21.1, C22.1, R1.2; also elsewhere on the board
+UB: V1.14 (+UB), V2.14 (+UB), V3.14 (+UB)
-UB: V1.7 (-UB), V2.7 (-UB), V3.7 (-UB)
ANA_DECOUP: C3.1, L1.1, MCU.27 (VDDANA)
CAN-EXP_RX: MCU.96 (PB0), U$36.4 (RXD)
CAN-EXP_TX: MCU.97 (PB1), U$36.1 (TXD)
CANEXP_N: U$36.6 (CANL)
CANEXP_P: U$36.7 (CANH)
CAN_N: U$4.6 (CANL)
CAN_P: U$4.7 (CANH)
CAN_RX: MCU.7 (PB4), U$4.4 (RXD)
CAN_TX: MCU.8 (PB5), U$4.1 (TXD)
CAPCURR(S): MCU.14 (PA8); also elsewhere on the board
CAPVOLT: MCU.16 (PA10); also elsewhere on the board
CVMPURGE_V_R: MCU.58 (PC7); also elsewhere on the board
FAN1_PWM_R: MCU.63 (PC15); also elsewhere on the board
FAN1_TACH_R: MCU.68 (PC20); also elsewhere on the board
FAN2_PWM_R: MCU.62 (PC14); also elsewhere on the board
FAN2_TACH_R: MCU.67 (PC19); also elsewhere on the board
FAN3_PWM_R: MCU.61 (PC13); also elsewhere on the board
FAN3_TACH_R: MCU.66 (PC18); also elsewhere on the board
FAN4_PWM_R: MCU.60 (PC12); also elsewhere on the board
FAN4_TACH_R: MCU.65 (PC17); also elsewhere on the board
FAN5_PWM_R: MCU.59 (PC11); also elsewhere on the board
FAN5_TACH_R: MCU.64 (PC16); also elsewhere on the board
FCCURR(S): MCU.15 (PA9); also elsewhere on the board
FCPRES_S+(S): R26.8 (2); also elsewhere on the board
FCPRES_S-(S): R26.7 (2); also elsewhere on the board
FCTEMP1: MCU.28 (PA20); also elsewhere on the board
FCTEMP2: MCU.29 (PA21); also elsewhere on the board
FCVOLT: MCU.17 (PA11); also elsewhere on the board
GND: 4-NMOS1.3, 4-NMOS1.4, 4-NMOS1.7, 4-NMOS1.8, 4-NMOS1.12, 4-NMOS2.8, 4-NMOS2.12, C3.2, C4.2, C5.2, C6.2, C7.2, C8.2, C9.2, C10.1, C11.-, C13.2, C14.2, C15.-, C16.2, C17.2, C18.2, C19.-, C20.-, C21.2, C22.2, C23.1, C27.1, C28.1, C29.1, JTAG.2, JTAG.10, MCU.6 (GNDIO1), MCU.26 (GNDANA), MCU.37 (GNDPLL), MCU.41 (GNDCORE), MCU.54 (GNDIO2), MCU.83 (GNDIO3), MODEBTN1.1, MODEBTN2.1, MODEBTN3.1, MODEBTN4.1, PWR_12.C, R4.2, R59.2, R60.2, R61.2, R62.2, R63.2, R68.5 (2), R68.6 (2), R68.7 (2), R68.8 (2), RESET.1, U$1.P$5 (GND), U$1.P$6 (GND2), U$2.10, U$4.2 (VSS/GND), U$4.8 (RS), U$36.2 (VSS/GND), U$36.8 (RS); also elsewhere on the board
LED0: MCU.44 (PB21); also elsewhere on the board
LED1: MCU.47 (PB30); also elsewhere on the board
LED2: MCU.42 (PB19); also elsewhere on the board
LED3: MCU.43 (PB20); also elsewhere on the board
LED_ERROR: 4-NMOS1.9, MCU.51 (PC2)
LED_RUN: 4-NMOS1.2, MCU.48 (PB31)
LED_START: 4-NMOS1.6, MCU.50 (PC1)
LED_STAT1: 4-NMOS2.2, MCU.86 (PD13)
LED_STAT2: 4-NMOS2.13, MCU.87 (PD14)
LED_STAT3: 4-NMOS2.3, 4-NMOS2.4, 4-NMOS2.6, 4-NMOS2.7, MCU.88 (PD21)
LED_STAT4: 4-NMOS2.9, MCU.89 (PD22)
LED_STOP: 4-NMOS1.13, MCU.52 (PC3)
MCU_RST: C10.2, JTAG.6, MCU.98 (!RESET), R23.1, RESET.3 (2); also elsewhere on the board
MFLOW(S): MCU.25 (PA19); also elsewhere on the board
MODEBTN1: C23.2, MCU.33 (PA25), MODEBTN1.3 (2), R11.1
MODEBTN2: C27.2, MCU.32 (PA24), MODEBTN2.3 (2), R12.1
MODEBTN3: C28.2, MCU.31 (PA23), MODEBTN3.3 (2), R58.1
MODEBTN4: C29.2, MCU.30 (PA22), MODEBTN4.3 (2), R64.1
unnamed: MCU.12 (PA6), R26.2 (1)
unnamed: MCU.13 (PA7), R26.1
unnamed: C6.1, C7.1, C14.1, MCU.39 (VDD_33)
unnamed: C8.1, C9.1, C16.1, MCU.40 (VDDCORE)
unnamed: C12.1, MCU.23 (ADCREFP)
unnamed: C12.2, MCU.24 (ADCREFN)
unnamed: MCU.69 (PC21), U$2.1
unnamed: MCU.70 (PC22), U$2.2
unnamed: MCU.71 (PC23), U$2.3
unnamed: LSTART.C, R7.5 (2)
unnamed: LRUN.C, R7.6 (2)
unnamed: MCU.72 (PC24), U$2.4
unnamed: MCU.73 (PC31), U$2.5
unnamed: 4-NMOS1.5, R7.4 (1)
unnamed: 4-NMOS1.1, R7.3 (1)
unnamed: PWR_12.A, R1.1
unnamed: MCU.74 (PD0), U$2.6
unnamed: MCU.75 (PD1), U$2.7
unnamed: 4-NMOS2.5, R65.4 (1)
unnamed: 4-NMOS2.1, R65.3 (1)
unnamed: 4-NMOS2.14, R65.2 (1)
unnamed: 4-NMOS2.10, R65.1
unnamed: LSTAT3.C, R65.5 (2)
unnamed: 4-NMOS1.14, R7.2 (1)
unnamed: 4-NMOS1.10, R7.1
unnamed: LSTOP.C, R7.7 (2)
unnamed: LERROR.C, R7.8 (2)
unnamed: LSTAT1.C, R65.6 (2)
unnamed: LSTAT2.C, R65.7 (2)
unnamed: LSTAT4.C, R65.8 (2)
unnamed: JTAG.8, R45.1
OP-1: MCU.95 (PD30), R68.4 (1), V2.12 (A)
OP-1S: V2.11 (Y); also elsewhere on the board
OP-2: MCU.94 (PD29), R68.3 (1), V2.9 (A)
OP-2S: V2.8 (Y); also elsewhere on the board
OP-3: MCU.93 (PD28), R68.2 (1), V2.4 (A)
OP-3S: V2.6 (Y); also elsewhere on the board
OP-4: MCU.92 (PD27), R68.1, V2.1 (A)
OP-4S: V2.3 (Y); also elsewhere on the board
OP-5: MCU.91 (PD24), R63.1, V1.9 (A)
OP-5S: V1.8 (Y); also elsewhere on the board
OP-6: MCU.85 (PD12), R62.1, V1.12 (A)
OP-6S: V1.11 (Y); also elsewhere on the board
OP-7: MCU.84 (PD11), R61.1, V1.4 (A)
OP-7S: V1.6 (Y); also elsewhere on the board
OP-8: MCU.81 (PD10), R60.1, V1.1 (A)
OP-8S: V1.3 (Y); also elsewhere on the board
OP-9: MCU.80 (PD9), R59.1, V3.4 (A)
OP-9S: V3.6 (Y); also elsewhere on the board
OP-10: R4.1, V3.1 (A)
OP-10S: V3.3 (Y); also elsewhere on the board
OPENLOG_DTR: MCU.57 (PC6), U$1.P$1 (DTR)
OPENLOG_RX: MCU.56 (PC5), U$1.P$3 (TXO)
OPENLOG_TX: MCU.55 (PC4), U$1.P$2 (RXI), U$2.8
START(S): MCU.100 (PB3); also elsewhere on the board
SYS_OK: MCU.99 (PB2), V1.2 (B), V1.5 (B), V1.10 (B), V1.13 (B), V2.2 (B), V2.5 (B), V2.10 (B), V2.13 (B), V3.2 (B), V3.5 (B); also elsewhere on the board
TCK: JTAG.1, MCU.1 (PA0)
TDI: JTAG.9, MCU.2 (PA1)
TDO: JTAG.3, MCU.3 (PA2)
TMS: JTAG.5, MCU.4 (PA3)
USB_N: MCU.35 (DM)
USB_P: MCU.36 (DP)
USB_VBUS: MCU.34 (VBUS)
VCC: 4-NMOS1.11, 4-NMOS2.11, C4.1, C5.1, C11.+, C13.1, C15.+, C17.1, C18.1, JTAG.4, JTAG.7, L1.2, LERROR.A, LRUN.A, LSTART.A, LSTAT1.A, LSTAT2.A, LSTAT3.A, LSTAT4.A, LSTOP.A, MCU.5 (VDDIO1), MCU.38 (VDD_5), MCU.53 (VDDIO2), MCU.82 (VDDIO3), R11.2, R12.2, R23.2, R45.2, R58.2, R64.2, U$1.P$4 (RAW), U$2.9, U$4.3 (VDD/5V), U$36.3 (VDD/5V); also elsewhere on the board

Notes on the sheet:
Choose Inductor
Use decoupling caps on ADCREF* pins. We'll use internal reference 2 which will allow ADC conversion +/-0.6 * VDDANA.
Close to Pin
Close to Device
Common for Groups
JTAG Port
(optional)
See page 1260 of Datasheet for info on Caps
CAN Transceiver
Clean Power and Lights
FCC Status Indicators
It's a spaceship.
pew pew
AND Gates
Screw Terminals Pins 69 to 76
SD Card openlogger

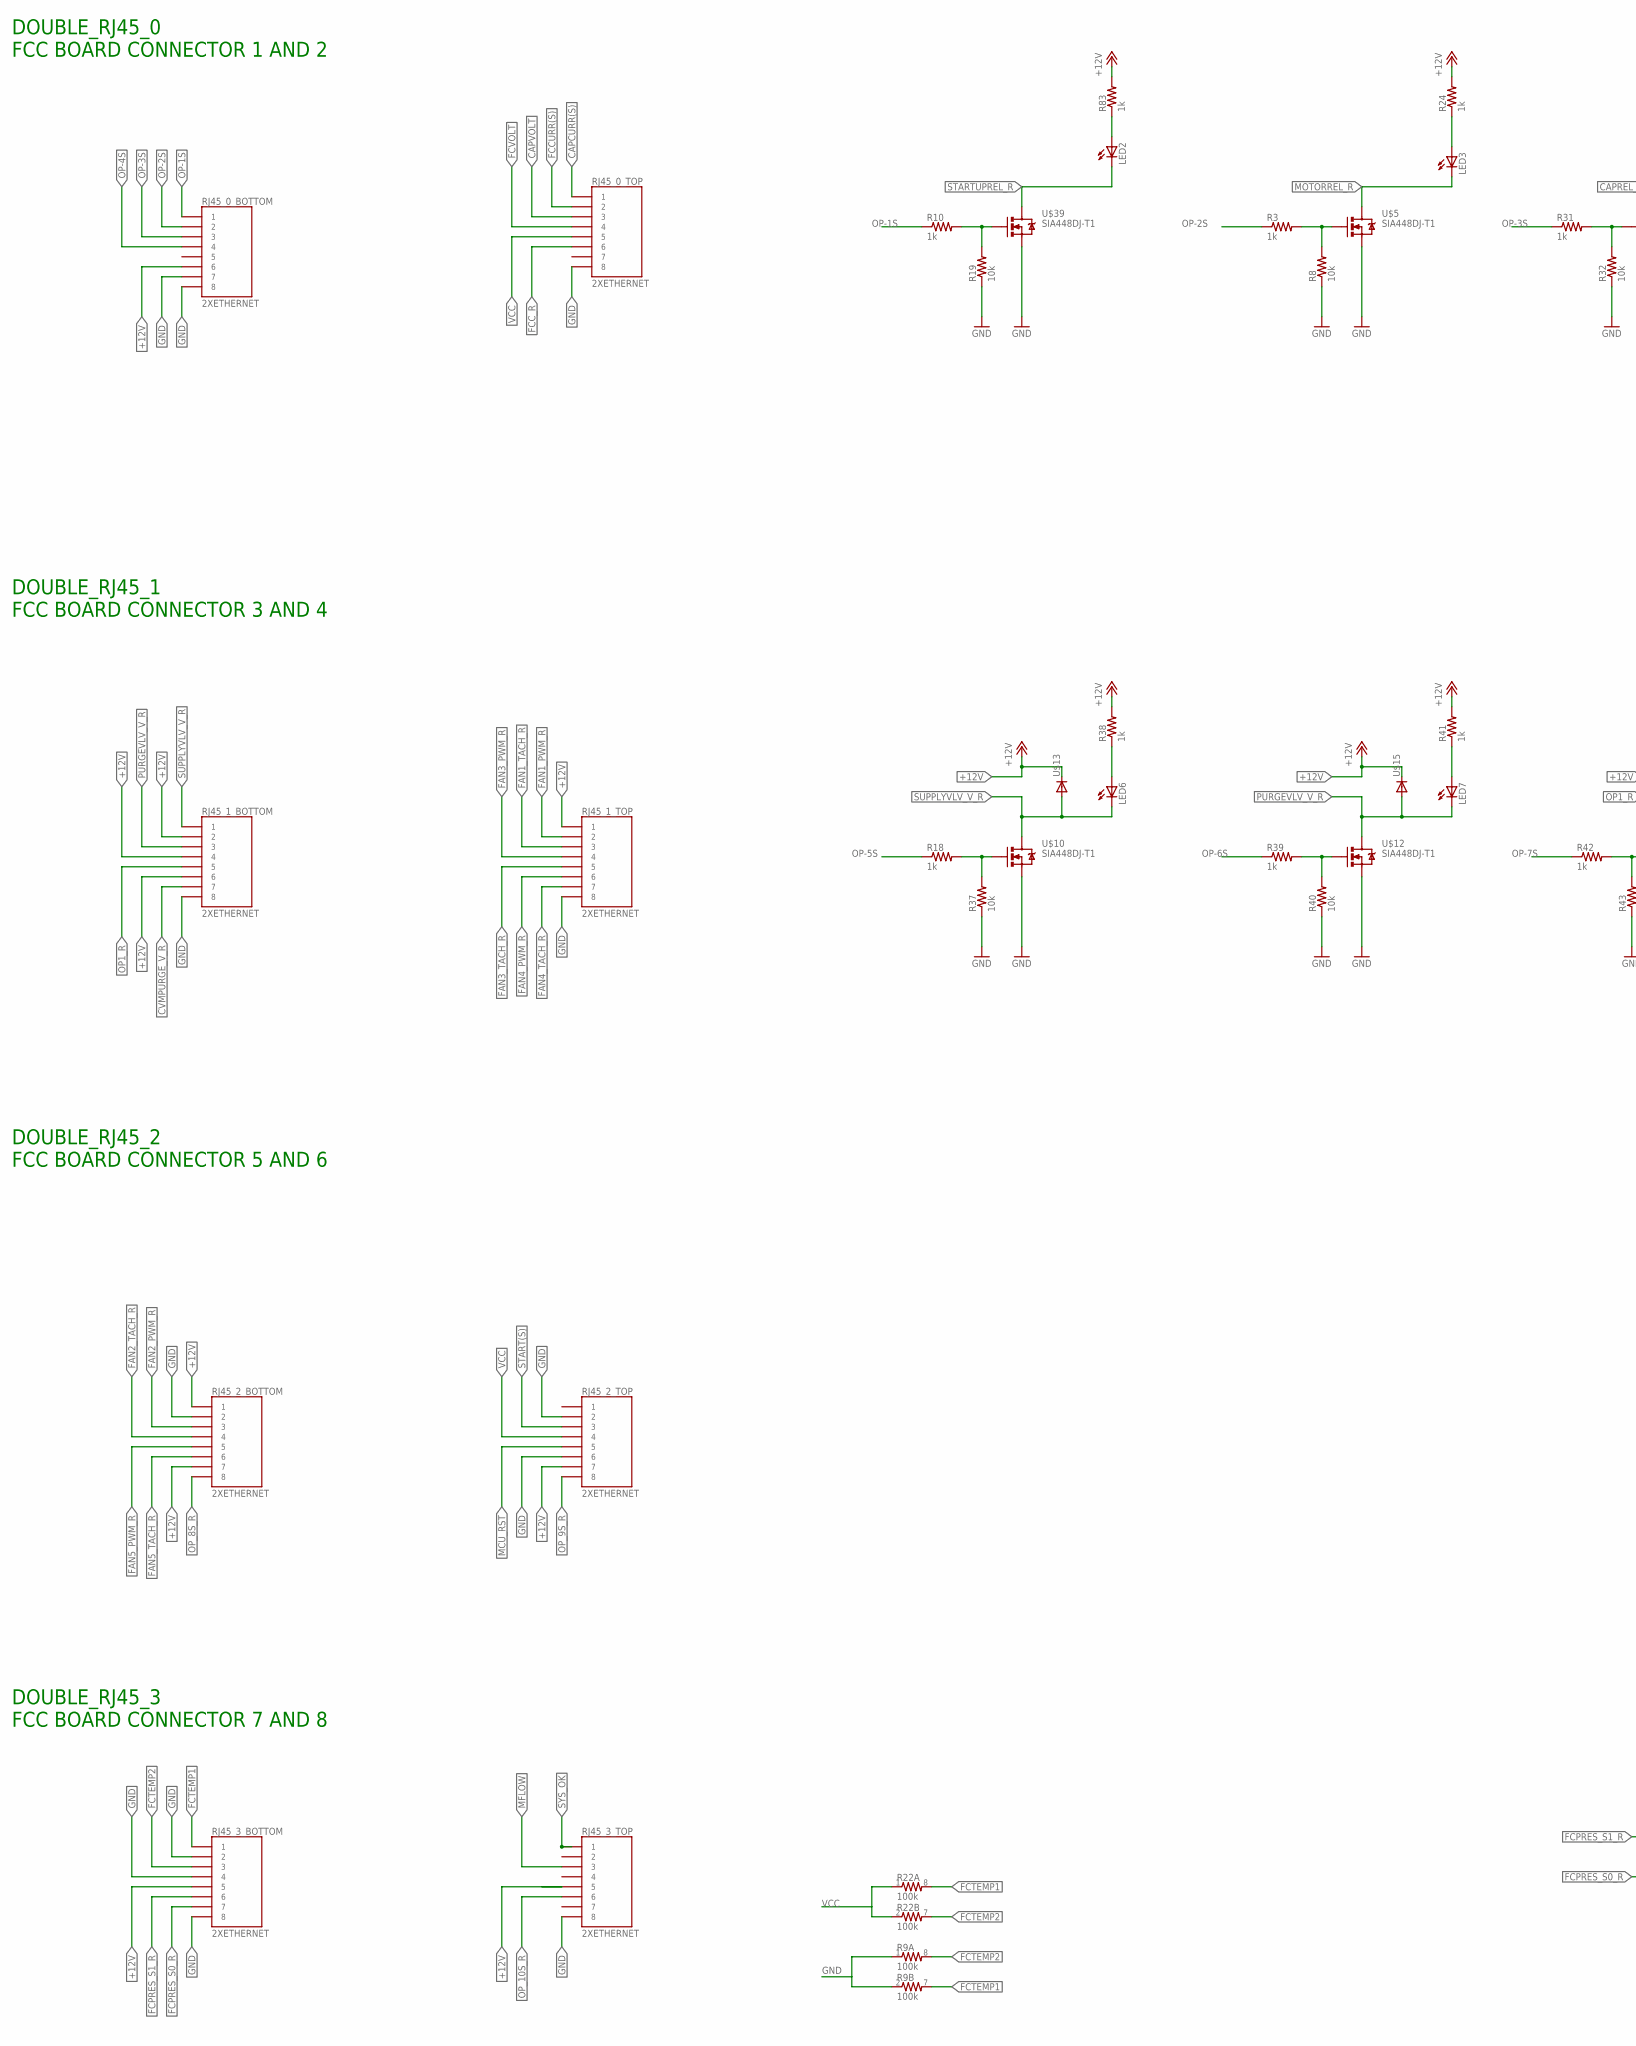
[picture p8: schematic E-P-206-R2.0.0_Fuel_Cell_Controller.sch, sheet 3, Ethernet I/O, part in row 1, column 1]

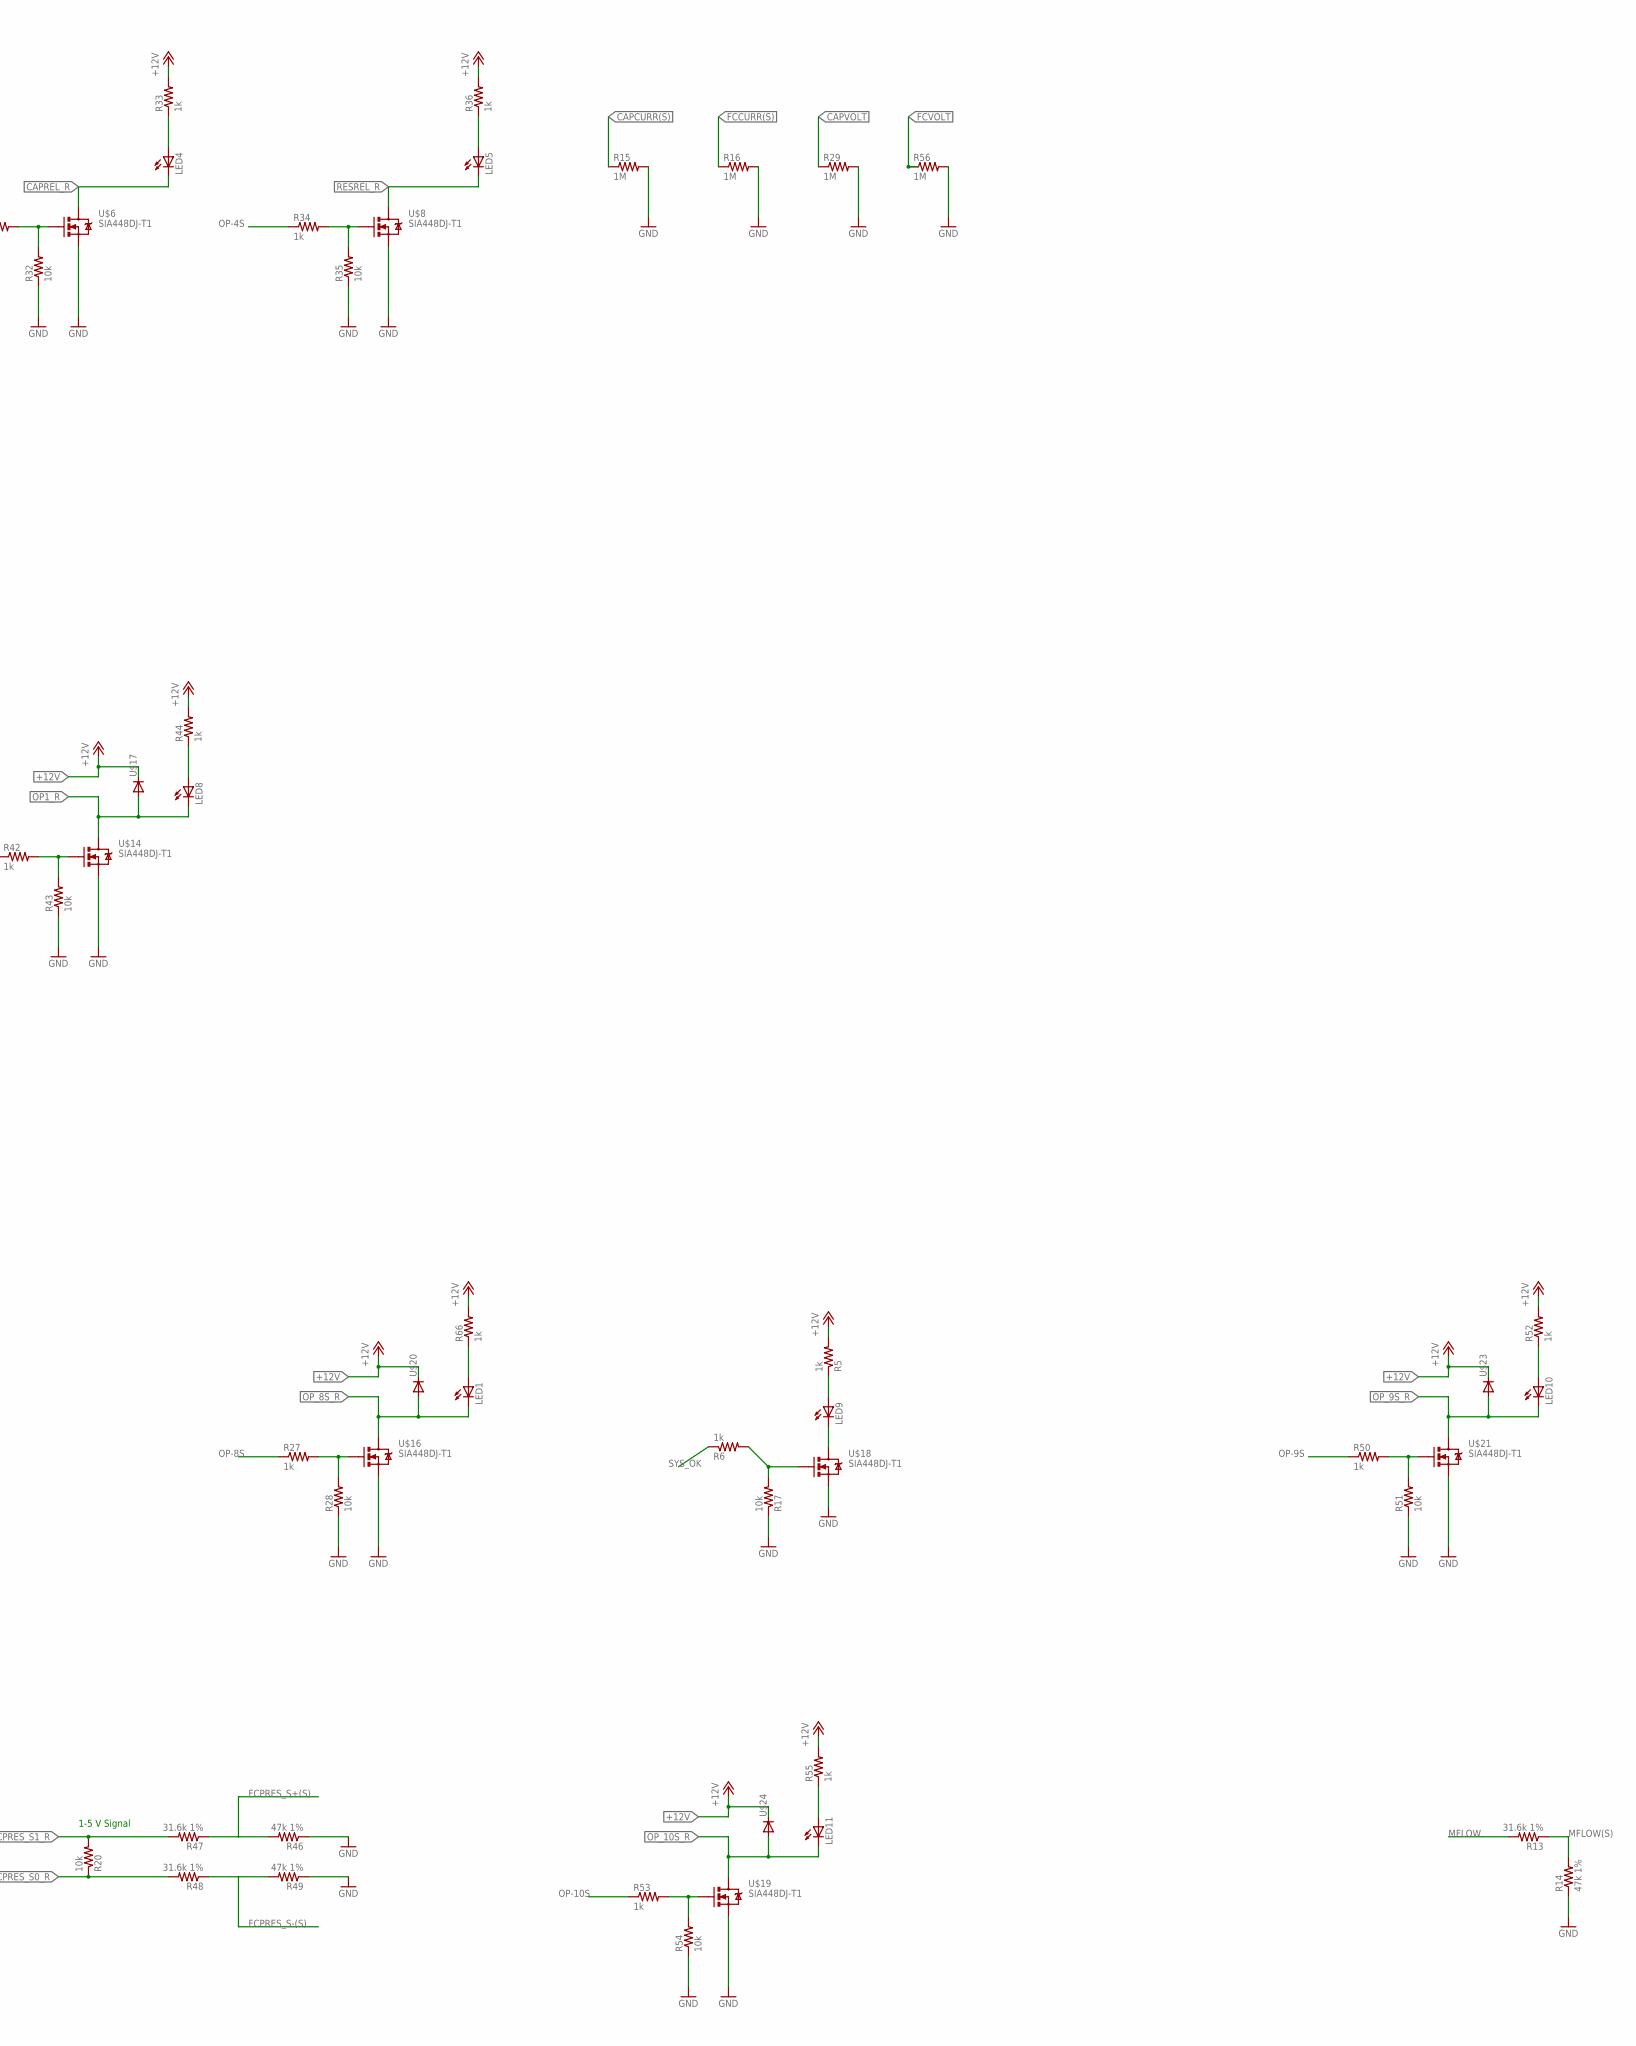
[picture p9: schematic E-P-206-R2.0.0_Fuel_Cell_Controller.sch, sheet 3, Ethernet I/O, part in row 1, column 2]

Parts:
LED1, LED2, LED3, LED4, LED5, LED6, LED7, LED8, LED9, LED10, LED11: LED1206; LED-1206
R3, R5, R6, R10, R18, R24, R27, R31, R33, R34, R36, R38, R39, R41, R42, R44, R50, R52, R53, R55, R66, R83: 1k; 0603-RES
R8, R17, R19, R20, R28, R32, R35, R37, R40, R43, R51, R54: 10k; 0603-RES
R9, R22: 100k; 0603-ARV
R13, R47, R48: 31.6k 1%; 0603-RES
R14, R46, R49: 47k 1%; 0603-RES
R15, R16, R29, R56: 1M; R0805
RJ45_0_, RJ45_1_, RJ45_2_, RJ45_3_: 2XETHERNET
U$5, U$6, U$8, U$10, U$12, U$14, U$16, U$18, U$19, U$21, U$39: SIA448DJ-T1; SC70-6L
U$13, U$15, U$17, U$20, U$23, U$24: DIODE-DO214AC; DO214AC

Connections:
+12V: R5.2, R24.2, R33.2, R36.2, R38.2, R41.2, R44.2, R52.2, R55.2, R66.2, R83.2, RJ45_0_.B_6 (6), RJ45_1_.B_2 (2), RJ45_1_.B_4 (4), RJ45_1_.B_6 (6), RJ45_1_.T_1 (1), RJ45_2_.B_1 (1), RJ45_2_.B_7 (7), RJ45_2_.T_7 (7), RJ45_3_.B_5 (5), RJ45_3_.T_5 (5), U$13.C, U$15.C, U$17.C, U$20.C, U$23.C, U$24.C; also elsewhere on the board
CAPCURR(S): R15.1, RJ45_0_.T_1 (1); also elsewhere on the board
CAPREL_R: LED4.C, U$6.D
CAPVOLT: R29.1, RJ45_0_.T_3 (3); also elsewhere on the board
CVMPURGE_V_R: RJ45_1_.B_7 (7); also elsewhere on the board
FAN1_PWM_R: RJ45_1_.T_2 (2); also elsewhere on the board
FAN1_TACH_R: RJ45_1_.T_3 (3); also elsewhere on the board
FAN2_PWM_R: RJ45_2_.B_3 (3); also elsewhere on the board
FAN2_TACH_R: RJ45_2_.B_4 (4); also elsewhere on the board
FAN3_PWM_R: RJ45_1_.T_4 (4); also elsewhere on the board
FAN3_TACH_R: RJ45_1_.T_5 (5); also elsewhere on the board
FAN4_PWM_R: RJ45_1_.T_6 (6); also elsewhere on the board
FAN4_TACH_R: RJ45_1_.T_7 (7); also elsewhere on the board
FAN5_PWM_R: RJ45_2_.B_5 (5); also elsewhere on the board
FAN5_TACH_R: RJ45_2_.B_6 (6); also elsewhere on the board
FCCURR(S): R16.1, RJ45_0_.T_2 (2); also elsewhere on the board
FCC_R: RJ45_0_.T_6 (6)
FCPRES_S0_R: R20.1, R48.2, RJ45_3_.B_7 (7)
FCPRES_S1_R: R20.2, R47.2, RJ45_3_.B_6 (6)
FCPRES_S+(S): R46.2, R47.1; also elsewhere on the board
FCPRES_S-(S): R48.1, R49.2; also elsewhere on the board
FCTEMP1: R9.7 (2), R22.8 (2), RJ45_3_.B_1 (1); also elsewhere on the board
FCTEMP2: R9.8 (2), R22.7 (2), RJ45_3_.B_3 (3); also elsewhere on the board
FCVOLT: R56.1, RJ45_0_.T_4 (4); also elsewhere on the board
GND: R8.1, R9.1, R9.2 (1), R14.1, R15.2, R16.2, R17.1, R19.1, R28.1, R29.2, R32.1, R35.1, R37.1, R40.1, R43.1, R46.1, R49.1, R51.1, R54.1, R56.2, RJ45_0_.B_7 (7), RJ45_0_.B_8 (8), RJ45_0_.T_8 (8), RJ45_1_.B_8 (8), RJ45_1_.T_8 (8), RJ45_2_.B_2 (2), RJ45_2_.T_2 (2), RJ45_2_.T_6 (6), RJ45_3_.B_2 (2), RJ45_3_.B_4 (4), RJ45_3_.B_8 (8), RJ45_3_.T_8 (8), U$5.S@0 (S), U$5.S@1 (S), U$6.S@0 (S), U$6.S@1 (S), U$8.S@0 (S), U$8.S@1 (S), U$10.S@0 (S), U$10.S@1 (S), U$12.S@0 (S), U$12.S@1 (S), U$14.S@0 (S), U$14.S@1 (S), U$16.S@0 (S), U$16.S@1 (S), U$18.S@0 (S), U$18.S@1 (S), U$19.S@0 (S), U$19.S@1 (S), U$21.S@0 (S), U$21.S@1 (S), U$39.S@0 (S), U$39.S@1 (S); also elsewhere on the board
MCU_RST: RJ45_2_.T_5 (5); also elsewhere on the board
MFLOW: R13.2, RJ45_3_.T_3 (3)
MFLOW(S): R13.1, R14.2; also elsewhere on the board
MOTORREL_R: LED3.C, U$5.D
unnamed: LED9.A, R5.1
unnamed: R10.2, R19.2, U$39.G
unnamed: LED9.C, U$18.D
unnamed: R3.2, R8.2, U$5.G
unnamed: LED2.A, R83.1
unnamed: R31.2, R32.2, U$6.G
unnamed: LED3.A, R24.1
unnamed: R34.2, R35.2, U$8.G
unnamed: LED4.A, R33.1
unnamed: R18.2, R37.2, U$10.G
unnamed: LED5.A, R36.1
unnamed: R27.2, R28.2, U$16.G
unnamed: R39.2, R40.2, U$12.G
unnamed: LED6.A, R38.1
unnamed: R42.2, R43.2, U$14.G
unnamed: LED7.A, R41.1
unnamed: R50.2, R51.2, U$21.G
unnamed: LED8.A, R44.1
unnamed: R53.2, R54.2, U$19.G
unnamed: R6.2, R17.2, U$18.G
unnamed: LED1.A, R66.1
unnamed: LED10.A, R52.1
unnamed: LED11.A, R55.1
OP1_R: LED8.C, RJ45_1_.B_5 (5), U$14.D, U$17.A
OP-1S: R10.1, RJ45_0_.B_1 (1); also elsewhere on the board
OP-2S: R3.1, RJ45_0_.B_2 (2); also elsewhere on the board
OP-3S: R31.1, RJ45_0_.B_3 (3); also elsewhere on the board
OP-4S: R34.1, RJ45_0_.B_4 (4); also elsewhere on the board
OP-5S: R18.1; also elsewhere on the board
OP-6S: R39.1; also elsewhere on the board
OP-7S: R42.1; also elsewhere on the board
OP-8S: R27.1; also elsewhere on the board
OP-9S: R50.1; also elsewhere on the board
OP-10S: R53.1; also elsewhere on the board
OP_8S_R: LED1.C, RJ45_2_.B_8 (8), U$16.D, U$20.A
OP_9S_R: LED10.C, RJ45_2_.T_8 (8), U$21.D, U$23.A
OP_10S_R: LED11.C, RJ45_3_.T_6 (6), U$19.D, U$24.A
PURGEVLV_V_R: LED7.C, RJ45_1_.B_3 (3), U$12.D, U$15.A
RESREL_R: LED5.C, U$8.D
START(S): RJ45_2_.T_3 (3); also elsewhere on the board
STARTUPREL_R: LED2.C, U$39.D
SUPPLYVLV_V_R: LED6.C, RJ45_1_.B_1 (1), U$10.D, U$13.A
SYS_OK: R6.1, RJ45_3_.T_1 (1); also elsewhere on the board
VCC: R22.1, R22.2 (1), RJ45_0_.T_5 (5), RJ45_2_.T_4 (4); also elsewhere on the board

Notes on the sheet:
DOUBLE_RJ45_0 FCC BOARD CONNECTOR 1 AND 2
DOUBLE_RJ45_1 FCC BOARD CONNECTOR 3 AND 4
DOUBLE_RJ45_2 FCC BOARD CONNECTOR 5 AND 6
DOUBLE_RJ45_3 FCC BOARD CONNECTOR 7 AND 8
1-5 V Signal

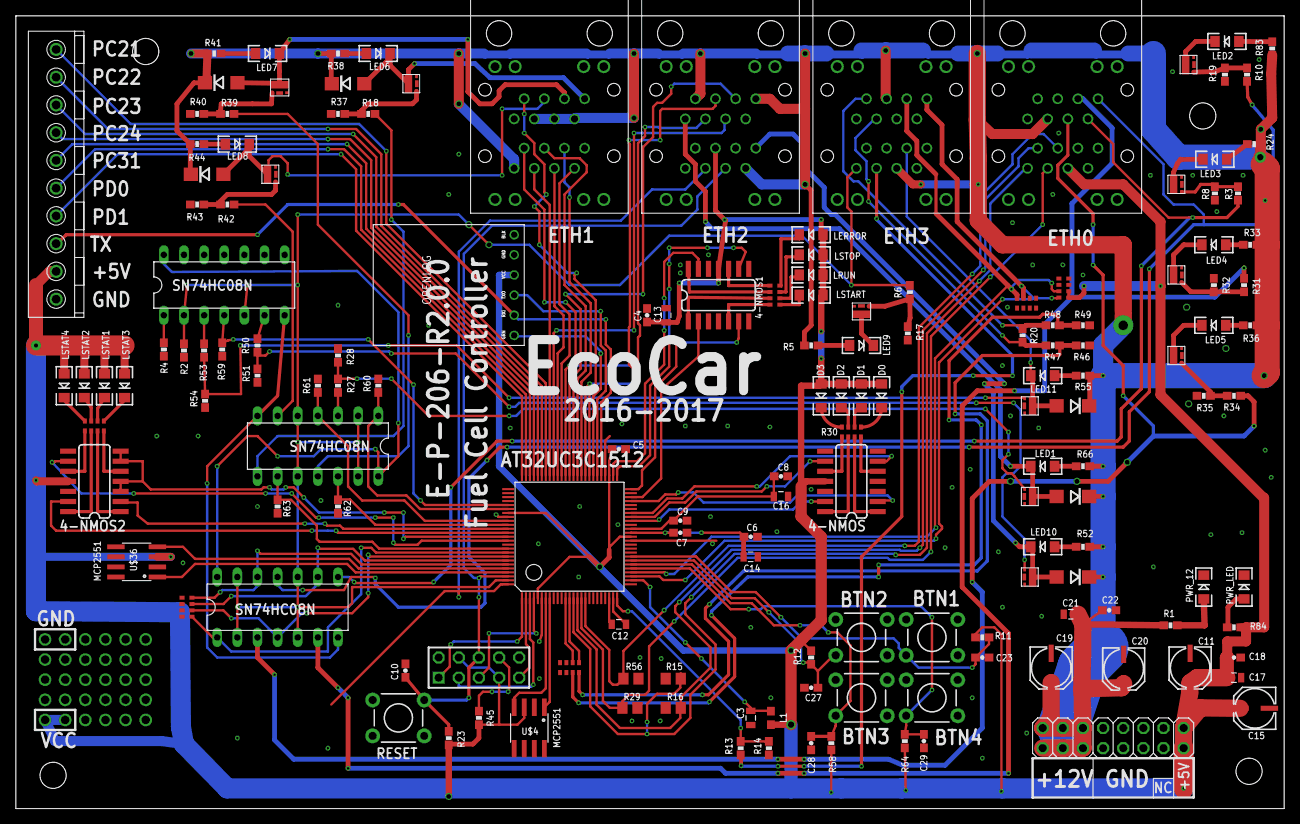
[picture p10: board E-P-206-R2.0.0_Fuel_Cell_Controller.brd from above]

Board: 2 copper layers, 160.0 x 100.0 mm, 159 parts (0 on the bottom side), 152 nets.

Other parts of the board:
U$3, U$22, U$25, U$27: STAND-OFF
