UAlberta-EcoCar/FCC-code-2015-2016/FCC-code_V2/FCCV2/FCCV2/src/analog_defs.h

/*
 * analog_defs.h
 *
 * Created: 2015-11-09 6:22:20 PM
 *  Author: Reegan
 */ 
#ifndef ANALOG_DEFS_H_
#define ANALOG_DEFS_H_
//Analog Inputs
#define FCTEMP2 AVR32_ADCIN10_PIN
#define FCTEMP1 AVR32_ADCIN9_PIN
#define MFLOW AVR32_ADCIN8_PIN
#define FCVOLT AVR32_ADCIN7_PIN
#define CAPVOLT AVR32_ADCIN6_PIN
#define FCCURR AVR32_ADCIN5_PIN
#define CAPCURR AVR32_ADCIN4_PIN
#define FCPRES AVR32_ADCIN3_PIN    
//adcin2 unused                    
//adcin1 unused                    
//adcin0 unused
//Analog GPIO MAP
static const gpio_map_t ADCIFA_GPIO_MAP = {
    //{MODEBTN1,AVR32_ADCIN14_FUNCTION},  
    //{MODEBTN2,AVR32_ADCIN13_FUNCTION},  
    //{MODEBTN3,AVR32_ADCIN12_FUNCTION},  
    //{MODEBTN4,AVR32_ADCIN11_FUNCTION},  
    {FCTEMP2,AVR32_ADCIN10_FUNCTION},
    {FCTEMP1,AVR32_ADCIN9_FUNCTION},
    {MFLOW,AVR32_ADCIN8_FUNCTION},
    {FCVOLT,AVR32_ADCIN7_FUNCTION},
    {CAPVOLT,AVR32_ADCIN6_FUNCTION},
    {FCCURR,AVR32_ADCIN5_FUNCTION},
    {CAPCURR,AVR32_ADCIN4_FUNCTION},
    {FCPRES,AVR32_ADCIN3_FUNCTION},
    //adcin 1 unused
};
//ADC settings
adcifa_opt_t adcifa_opt = {
    .frequency                = 250000,  // ADC frequency (Hz) //worked at 10000 and 250000, 500000
    .reference_source         = ADCIFA_REF06VDD, // Reference Source 0.6*5V = 3V
    .sample_and_hold_disable  = 0,    // Disable Sample and Hold Time
    .single_sequencer_mode    = 0,    // Single Sequencer Mode
    .free_running_mode_enable = 0,    // Free Running Mode
    .sleep_mode_enable        = 0     // Sleep Mode
};
adcifa_sequencer_opt_t adcifa_sequence_opt = {
    .convnb               = 7, // Number of sequence
    .resolution           = ADCIFA_SRES_12B,         // Resolution selection //12bits = 11bits + sign bit
    .trigger_selection    = ADCIFA_TRGSEL_SOFT,      // Trigger selection
    .start_of_conversion  = ADCIFA_SOCB_ALLSEQ,      // Conversion Management
    .half_word_adjustment = ADCIFA_HWLA_NOADJ,       // Half word Adjustment
    .software_acknowledge = ADCIFA_SA_NO_EOS_SOFTACK // Software Acknowledge
};
adcifa_sequencer_conversion_opt_t adcifa_sequence_conversion_option_0[7] =
{
    {
        .channel_p = AVR32_ADCIFA_INP_GNDANA,   // Positive Channel
        .channel_n = AVR32_ADCIFA_INN_ADCIN8,   // Negative Channel
        .gain      = ADCIFA_SHG_1                     // Gain of the conversion
    },
    {
        .channel_p = AVR32_ADCIFA_INP_GNDANA,             // Positive Channel
        .channel_n = AVR32_ADCIFA_INN_ADCIN9,             // Negative Channel
        .gain      = ADCIFA_SHG_1                     // Gain of the conversion
    },
    {
        .channel_p = AVR32_ADCIFA_INP_GNDANA,             // Positive Channel
        .channel_n = AVR32_ADCIFA_INN_ADCIN10,             // Negative Channel
        .gain      = ADCIFA_SHG_1                     // Gain of the conversion
    },
    {
        .channel_p = AVR32_ADCIFA_INP_GNDANA,             // Positive Channel
        .channel_n = AVR32_ADCIFA_INN_ADCIN11,             // Negative Channel
        .gain      = ADCIFA_SHG_1                     // Gain of the conversion
    },
    {
        .channel_p = AVR32_ADCIFA_INP_GNDANA,             // Positive Channel
        .channel_n = AVR32_ADCIFA_INN_ADCIN12,             // Negative Channel
        .gain      = ADCIFA_SHG_1                     // Gain of the conversion
    },
    {
        .channel_p = AVR32_ADCIFA_INP_GNDANA,             // Positive Channel
        .channel_n = AVR32_ADCIFA_INN_ADCIN13,             // Negative Channel
        .gain      = ADCIFA_SHG_1                     // Gain of the conversion
    },
    {
        .channel_p = AVR32_ADCIFA_INP_GNDANA,             // Positive Channel
        .channel_n = AVR32_ADCIFA_INN_ADCIN14,             // Negative Channel
        .gain      = ADCIFA_SHG_1                     // Gain of the conversion
    },
};
adcifa_sequencer_conversion_opt_t adcifa_sequence_conversion_option_1[6] =
{
    {
        .channel_p = AVR32_ADCIFA_INP_ADCIN0,             // Positive Channel
        .channel_n = AVR32_ADCIFA_INN_GNDANA,             // Negative Channel
        .gain      = ADCIFA_SHG_1                     // Gain of the conversion
    },
    {
        .channel_p = AVR32_ADCIFA_INP_ADCIN2,             // Positive Channel
        .channel_n = AVR32_ADCIFA_INN_GNDANA,             // Negative Channel
        .gain      = ADCIFA_SHG_1                     // Gain of the conversion
    },
    {
        .channel_p = AVR32_ADCIFA_INP_ADCIN4,             // Positive Channel
        .channel_n = AVR32_ADCIFA_INN_GNDANA,             // Negative Channel
        .gain      = ADCIFA_SHG_1                     // Gain of the conversion
    },
    {
        .channel_p = AVR32_ADCIFA_INP_ADCIN5,             // Positive Channel
        .channel_n = AVR32_ADCIFA_INN_GNDANA,             // Negative Channel
        .gain      = ADCIFA_SHG_1                     // Gain of the conversion
    },
    {
        .channel_p = AVR32_ADCIFA_INP_ADCIN6,             // Positive Channel
        .channel_n = AVR32_ADCIFA_INN_GNDANA,             // Negative Channel
        .gain      = ADCIFA_SHG_1                     // Gain of the conversion
    },
    {
        .channel_p = AVR32_ADCIFA_INP_ADCIN7,             // Positive Channel
        .channel_n = AVR32_ADCIFA_INN_GNDANA,             // Negative Channel
        .gain      = ADCIFA_SHG_1                     // Gain of the conversion
    },
};
//these are based off of the sequencer order in analog_defs.h
#define MFLOWReading adcvals_0[0] //sequencer 0 adcin8
#define FCTEMP1Reading ((readvals_0a[1] + readvals_0b[1] + readvals_0c[1]+ readvals_0d[1])/4) //seq 0 adcin9
#define FCTEMP2Reading ((readvals_0a[2] + readvals_0b[2] + readvals_0c[2]+ readvals_0d[2])/4) //seq 0 adcin10
//ambtemp not used atm
#define AMBTEMP1Reading adcvals_0[3] //seq 0 adcin11
#define AMBTEMP2Reading adcvals_0[4] //seq 0 adcin12
#define AMBTEMP3Reading adcvals_0[5] //seq 0 adcin13
#define AMBTEMP0Reading adcvals_0[6] //seq 0 adcin14
//these are based off the sequencer order in analog_defs.h
#define TANKPRESReading adcvals_1[0] //seq 1 adcin1
#define FCPRESReading adcvals_1[1] //seq 1 adcin3
#define CAPCURRReading adcvals_1[2] //seq 1 adcin4
#define FCCURRReading ((readvals_1a[3] + readvals_1b[3] + readvals_1c[3]+ readvals_1d[3])/4)
#define CAPVOLTReading adcvals_1[4]
#define FCVOLTReading ((readvals_1a[5] + readvals_1b[5] + readvals_1c[5]+ readvals_1d[5])/4)
#endif /* ANALOG_DEFS_H_ */
