UAlberta-EcoCar/FCC-code-2015-2016/FCC-code_V2/FCCV2/FCCV2/src/digital_IO_defs.h

/*
 * IncFile1.h
 *
 * Created: 2015-10-10 1:47:04 PM
 *  Author: Reegan
 */ 
#ifndef FUELCELL_IO_H
#define FUELCELL_IO_H
//digital Inputs
#define MODEBTN1 AVR32_PIN_PA25
#define MODEBTN2 AVR32_PIN_PA24
#define MODEBTN3 AVR32_PIN_PA23
#define MODEBTN4 AVR32_PIN_PA22
#define FAN5_TACH_R AVR32_PIN_PD03
#define CVM_PROBE_DISCONNECT AVR32_PIN_PC17
#define FAN3_TACH_R AVR32_PIN_PC18
#define FAN2_TACH_R AVR32_PIN_PC19
#define FAN1_TACH_R AVR32_PIN_PC20
#define CVM_PURGE_V_R AVR32_PIN_PC07
#define START AVR32_PIN_PB03
#define SYSOK AVR32_PIN_PB02
//PB23 unused
//PC00 unused
//PB22 unused
//PD02 unused
//PC06 unused
//LEDs
#define LED0 AVR32_PIN_PB21
#define LED1 AVR32_PIN_PB30
#define LED2 AVR32_PIN_PB19
#define LED3 AVR32_PIN_PB20
#define LED_RUN AVR32_PIN_PB31
#define LED_START AVR32_PIN_PC01
#define LED_ERROR AVR32_PIN_PC02
#define LED_STOP AVR32_PIN_PC03
#define LED_STAT1 AVR32_PIN_PD13
#define LED_STAT2 AVR32_PIN_PD14
#define LED_STAT3 AVR32_PIN_PD21
#define LED_STAT4 AVR32_PIN_PD22
//Coil driving outputs
#define OP_1 AVR32_PIN_PD30
#define OP_2 AVR32_PIN_PD29
#define OP_3 AVR32_PIN_PD28
#define OP_4 AVR32_PIN_PD27
#define OP_5 AVR32_PIN_PD24
#define OP_6 AVR32_PIN_PD12
#define OP_7 AVR32_PIN_PD11
#define OP_8 AVR32_PIN_PD10
#define OP_9 AVR32_PIN_PD09
//PD08 unused
//digital outputs
//relays
#define START_RELAY OP_1
#define RES_RELAY OP_2
#define CAP_RELAY OP_3
#define MOTOR_RELAY OP_4
//valves
#define PURGE_VALVE OP_9
#define H2_VALVE OP_8
#endif /* INCFILE1_H_ */
