UAlberta-EcoCar/FCC-code-2015-2016/FCC-code_V2/FCCV2/FCCV2/src/FC_error_codes.h

/*
 * FC_error_codes.h
 *
 * Created: 2015-11-14 5:34:49 PM
 *  Author: Reegan
 */ 


#ifndef FC_ERROR_CODES_H_
#define FC_ERROR_CODES_H_

#include "FuelCell_mode_Select.h"


//each error code sets a bit in "error" value
#define FC_ERR_CAP_DISC (1 << 0)
#define FC_ERR_FC_DISC (1 << 1)
#define FC_ERR_RES_DISC (1 << 2)
//note "DISC" == disconnected
#define FC_ERR_H2OK_LOW (1 << 3) //emergency stop
//temperatures
#define FC_ERR_TEMP_L  0//(1 << 4) //(-10C)
#define FC_ERR_TEMP_H (1 << 5) //(75C)
//pressure
#define FC_ERR_PRES_H (1 << 6) //(9.81 PSI)
#define FC_ERR_PRES_L (1 << 7) //only checked in purge, charge run (0.8 PSI)
//current
#define FC_ERR_OVER_CUR (1 << 8) //(78A)
#define FC_ERR_UND_CUR (1 << 9) //(-3A)
//voltage
#define FC_ERR_OVER_VOLT (1 << 10) // (50.6V)
#define FC_ERR_VOLT_LOW (1 << 11) //capacitor low
#define FC_ERR_WDT (1 << 12) //watch dog timer
#define FC_ERR_BOD (1 << 13) //brown out detection
#define FC_ERR_PWR_BAD (1 << 14)
#define FC_ERR_PURGE_PRESS_LOW (1 << 15)


//define thresholds for over current etc
#define LOW_TEMP_THRES 270000 //0C. 
#define HIGH_TEMP_THRES 348000 // 75C
#define FC_HIGH_PRES_THRES 10000 //10 PSI
#define FC_LOW_PRES_THRES 2000 //2.5 PSI
#define OVER_CUR_THRES 75000 //75A
#define UNDER_CUR_THRES 0 //only possible if sensor is disconnected if in start purge 
#define OVER_VOLT_THRES 50600 //50.6V
#define LOW_VOLT_THRES 15000 //capacitors are drained too much 15V
#define PURGE_PRESS_LOW_THRES 1000



#define ERROR_MASK (!(FC_ERR_PRES_L))


#endif /* FC_ERROR_CODES_H_ */
