UAlberta-EcoCar/FCC-code-2015-2016/FCC-code_V2/FCCV2/FCCV2/src/FuelCell_ADC.h

/*
 * FuelCell_ADC.h
 *
 * Created: 2015-11-09 6:26:42 PM
 *  Author: Reegan
 */ 


#ifndef FUELCELL_ADC_H_
#define FUELCELL_ADC_H_



void ADCInit(void);
void StartADC_Sequencers(void);
void ReadADC_Sequencers(void);

int convert_temp(int temp_reading);
int get_FCTEMP(void);

int get_FCPRES(void);

int get_CAPCURR(void);

int get_CAPVOLT(void);

int get_FCVOLT(void);

int get_FCCURR(void);

#endif /* FUELCELL_ADC_H_ */
