UAlberta-EcoCar/FCC-code-2015-2016/(commit log)

2015-10-03 Update
    Cleaned up OP defs and added LED defs
2015-10-04 Have ADC figured out
2015-10-04 ADC code should work. We can start testing inputs and outputs
2015-10-10 Might have fixed timer and adc... It is also possible I didn't
2015-10-22 Rewired CAPCON pin
2015-10-26 adc code
2015-11-07 Added PWM libraries
2015-11-10 millis function
2015-11-10 started to look at pwm. everything still compiles (somehow)
2015-11-10 updated pwm settings
2015-11-10 pwm signal somehow works
2015-11-10 no longer need to enable channel 0 for channel 2 to work
    [main.c]
2015-11-14 millis works. I changed part of pwm code. I hope I didn't break it
    [FuelCell_Functions.c, FuelCell_PWM.c, FuelCell_PWM.h, main.c]
2015-11-14 cool led blinking pattern
2015-11-15 check for errors function
    checks fuel cell error conditions. need to set thresholds
    [FC_error_codes.h, FuelCell_Functions.c, FuelCell_Functions.h, main.c]
2015-11-15 very simple fan control
2015-11-22 Pressure sensor conversions
2015-11-28 fixed some of purge timing
    [FC_error_codes.h, FuelCell_Functions.c, FuelCell_Functions.h, analog_defs.h, digital_IO_defs.h, main.c]
2015-11-28 adc re-done
2015-11-29 changed adc settings switch back if it doesn't work
    [FuelCell_ADC.c, FuelCell_Functions.c, FuelCell_Functions.h, analog_defs.h]
2015-12-05 improved(?) thermistor conversion
2015-12-13 increased pwm resolution
2015-12-14 watchdog timer
2015-12-22 watch dog timer works
2015-12-29 Fixed some formatting with the data reporting over USART
    [main.c]
2016-01-06 Merge remote-tracking branch 'origin/master'
    fixing merge conflicts
    [FC_error_codes.h, FuelCell_ADC.c, FuelCell_ADC.h, FuelCell_PWM.c, FuelCell_check_alarms.c, analog_defs.h]
2016-01-06 apparently C switch statements need a break; after each case
2016-01-16 Adjust conversions for use with 10V test bench simply by defining TEST_BENCH_MODE in mode select file
2016-01-22 added function that keep track of amount of charge used
2016-01-30 Bug fix: error codes were clearing themselves
    [main.c]
2016-01-30 last commit should have been "for startup charge state"
2016-02-17 Switched to CAN channel 1 hopefully that was the issue
2016-02-17 CAN BUS not sending
2016-02-18 Rewriting CAN-BUS code
    Based CANInit function off of 3 examples: It didn't work.
    The good news: connecting FCC doesn't wreck rest of CAN-BUS
    [main.c]
2016-02-19 more alarm checking
    start led should now turn off in alarm state
2016-02-19 Negative numbers were messing with PWM
2016-02-26 Fixed some conversions
    [Temp conversion.xlsx]
2016-02-28 Fixed current conversion
    Also added equation to calc recommended max/min temps at certain current
    levels
    [FC_error_codes.h, FuelCell_ADC_conversion_consts.h, FuelCell_Functions.c, FuelCell_Functions.h, main.c]
2016-03-06 Moved arduino code
2016-03-08 current sensor working
    added in an average last 4 readings calculation
2016-03-10 Some changes to stop voltage spike when super caps are disconected
2016-03-27 More delays. overvolt error fixed
    [FC_error_codes.h, FuelCell_DataLogging.h, FuelCell_Functions.c, FuelCell_check_alarms.c, usart_data_log.py]
2016-03-27 It appears to work
    [Temp conversion.xlsx]
2016-04-22 Revert "Update"
    This reverts commit 422c26a4b5eee28be358b5c03d456db6e9e04c90.
    [FC_USART_CAN_BRIDGE.ino, FuelCell_DataLogging.h, FuelCell_Functions.c, fc_can_messages.cpp, main.c, pid.c]
2016-04-29 added submodule libraries for arduino code
    [Temp conversion.xlsx]
2016-06-11 Fuel cell pressure
    changed the constant for the pressure calculation to work with Adnans
    new formula
    Pressure now being read from S- instead of S+
2016-06-12 Pressure reading, changed usart baud rate
2016-06-12 Low pressure alarm works
2016-06-25 Low pressure alarm during purge
2016-07-01 Changed valve pin
2017-02-18 Defined Status LEDs and Buttons
2017-02-19 Finished updating the PWMs file
2017-02-21 removed PWM initialisation and updating for Fan 4. Also updated FanUpdate() return statement
2017-02-23 Fixed a few lines for manual depressurize and air starve, initialized tachometers, added blinking LEDs for manual depressurize and air starve
    [FuelCell_Functions.c, FuelCell_check_alarms.c, digital_IO_defs.h, main.c]
2017-02-24 Added Hardware folder with Eagle files for V1.0, V1.2 and V2.0
    [E-P-206-R1.0 Fuel Cell Control.brd, E-P-206-R1.0 Fuel Cell Control.sch, E-P-206-R1.2 Fuel Cell Control (Board to Board).brd, E-P-206-R1.2 Fuel Cell Control (Board to Board).sch, E-P-206-R2.0.0_Fuel_Cell_Controller.brd, E-P-206-R2.0.0_Fuel_Cell_Controller.sch]
2017-04-05 Cleaned up code, modified digital and analog IO's
    Cleaned up code
    Added semicolons, brackets etc. which were causing errors.
    Modified digital and analog IO's
    Made changes in analog_defs.h and digital_IO_defs.h to match AVR
    FCC R2.0 specs.
    [FuelCell_Functions.c, FuelCell_PWM.c, FuelCell_PWM.h, analog_defs.h, digital_IO_defs.h, main.c]
2017-04-06 Trying to fix last commit
    Digital IO defs and Analog defs were not updated due to some git
    issues. They have been updated with this commit. Please check
    previous git commit messages for the list of changes.
    [FuelCell_Functions.c, analog_defs.h, digital_IO_defs.h, main.c]
2017-04-06 Updated digital and analago defs
    Updated Pins for digital_IO_defs and analog_defs. Also renamed
    FAN TACH pins for FuelCell_Functions.
2017-04-10 Added USART defines for all pins
    Serial communication was successful by changing the Fan5 Tach pin to
    serial. This was the pin configured as serial in R1.2. This commit
    initialises all the serial pins available. Trial and error will be used
    to find the right pin define for R2.0. Datasheet does not match the code
    pin defines which is why this is being done.
    [FuelCell_Functions.c, FuelCell_USART.c, FuelCell_USART.h, digital_IO_defs.h, main.c]
2017-04-20 Corrected voltage calibrations for FC Voltage and Cap Voltage to reflect Relay Board V2. Calibration document is on GDrive.
    [FuelCell_ADC.c, FuelCell_ADC.h, FuelCell_ADC_conversion_consts.h, FuelCell_DataLogging.c, FuelCell_Functions.c, FuelCell_Functions.h, FuelCell_USART.h, main.c]
